WisdomSemestreI/Documentacion/WISDOM-GanntFinal.pdf

# SPARC - Wisdom

Recurso y Entregable

1 | Requerimientos | Lista electrónica
1 | Requerimientos | Lista electrónica
2 | Diseño estructural | Dibujo 2D del CAD
2 | Diseño estructural | Dibujo 2D del CAD
3 | Diseño Electrónico | Esquemático Digital
3 | Diseño Electrónico | Esquemático Digital
4 | Lista de Materiales | Excel
4 | Lista de Materiales | Excel
5 | Desarrollo de software | Github
5 | Desarrollo de software | Github
6 | Ensamblado final | Dispositivo
6 | Ensamblado final | Dispositivo
7 | Pruebas | Tabla de Pruebas
7 | Pruebas | Tabla de Pruebas
8 | Presentaciones | Documento digital e
| | impreso
8 | Presentaciones | Documento digital e
| | impreso
8.1 | Presentación 1: Semana inmersión 1 | Documento digital e
| | impreso
8.1 | Presentación 1: Semana inmersión 1 | Documento digital e
| | impreso
8.2 | Presentación avance Profe Cienfuegos | Documento digital
8.2 | Presentación avance Profe Cienfuegos | Documento digital
8.3 | Presentación 2: Semana inmersión 2 | Documento digital e
| | impreso
8.3 | Presentación 2: Semana inmersión 2 | Documento digital e
| | impreso
8.4 | Presentación avance Profe Cienfuegos | Documento digital
8.4 | Presentación avance Profe Cienfuegos | Documento digital

RESPONSABLE DEL PROYECTO

NÚMERO
EDT | TÍTULO DE LA TAREA

TÍTULO DEL PROYECTO

8.5 | Aprobación del Proyecto
8.5 | Aprobación del Proyecto

SPARC

Adriana L. Avitia, Arael Alvarez, Fernando Escudero

2 | 3 | 4 | 5 | 6 | 9 | 10 | 11 | 12 | 13 | 16 | 17 | 18 | 19 | 20 | 23 | 24 | 25 | 26

Adry

Adry

Fer

Fer

Adry

Adry

Adry

Adry

Ara

Ara

Ara

Ara

Fer

Fer

Adry

Adry

Adry

Adry

Adry

Adry

Adry

Adry

Adry

Adry

04/09/19

RESPONSABLE DE LA TAREA

FASE 1: REQUERIMIENTOS Y DISEÑO

SEMANA 4 | SEMANA 5 | SEMANA 6
L | M | X | J | V | L | M | X | J | V | L | M | X | J | V | L | M | X | J

SEPTIEMBRE

SEMANA 7

NOMBRE DE LA EMPRESA Tec de Monterrey Campus Chihuahua

FECHA

Etapa 1

FASE 2: MATERIALES Y FASE 3: DESARROLLO DE SOFTWARE

Realización Planeada

Fecha importante | Realización Real
V | L | M | X | J | V | L | M | X | J | V | L | M | X | J | V | L | M | X | J | V | L | M | X | J
27 | 30 | 1 | 2 | 3 | 4 | 7 | 8 | 9 | 10 | 11 | 14 | 15 | 16 | 17 | 18 | 21 | 22 | 23 | 24 | 25 | 28 | 29 | 30 | 31

OCTUBRE

SEMANA 8 | SEMANA 9 | SEMANA 10 | SEMANA 11 | SEMANA 12

Etapa 2

FASE 4: EMSAMBLAJE Y PRUEBAS

1 | 4 | 5 | 6 | 7 | 8 | 11 | 12 | 13 | 14 | 15 | 18 | 19 | 20 | 21 | 22 | 25 | 26 | 27 | 28 | 29 | 2 | 3 | 4 | 5
SEMANA 14 | SEMANA 15 | SEMANA 16 | SEMANA 17
NOVIEMBRE | DICIEMBRE

SEMANA 13

V | L | M | X | J | V | L | M | X | J | V | L | M | X | J | V | L | M | X | J | V | L | M | X | J

Etapa 3

FASE 5: CORRECIONES Y PRESENTACIÓN

V

6
