WisdomSemestreI/Documentacion/Arquitectura de software.png

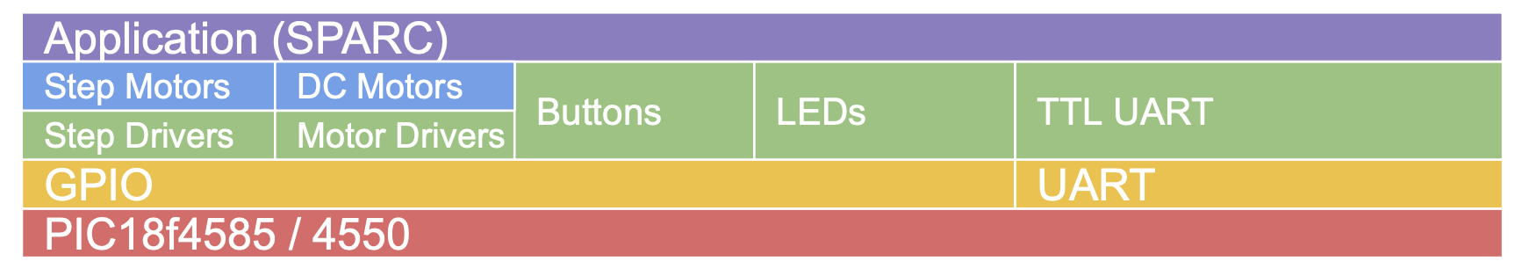
Arquitectura de software.png
