WisdomSemestreI/Documentacion/DeploymentDiagram.png

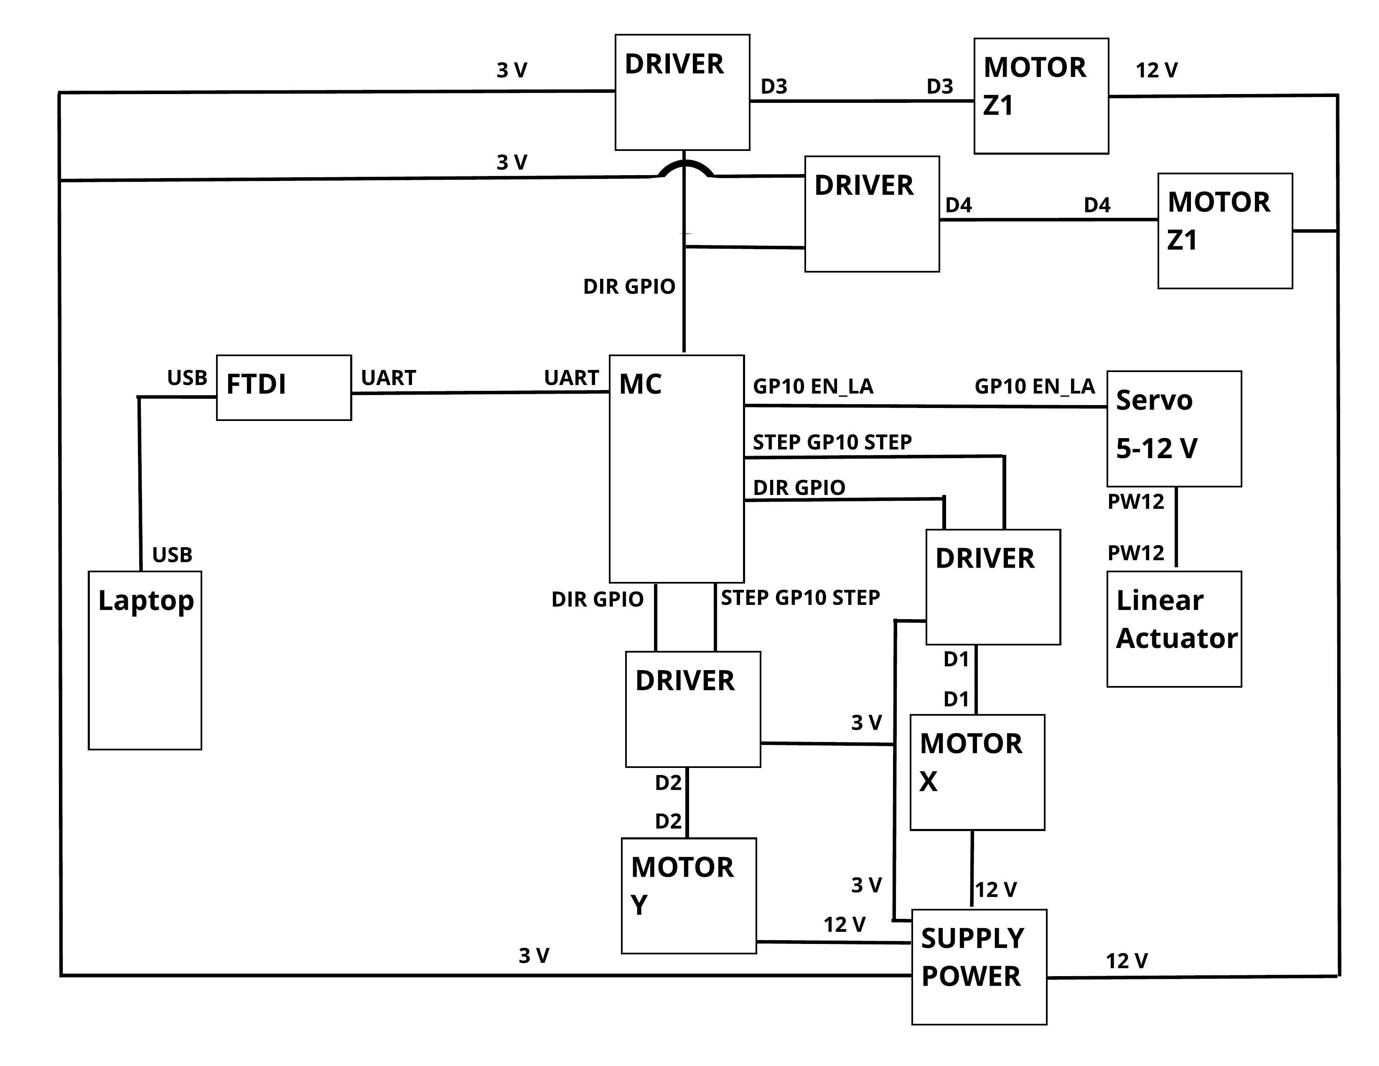
DeploymentDiagram.png
