WisdomSemestreI/Documentacion/Diagrama de Flujo.png

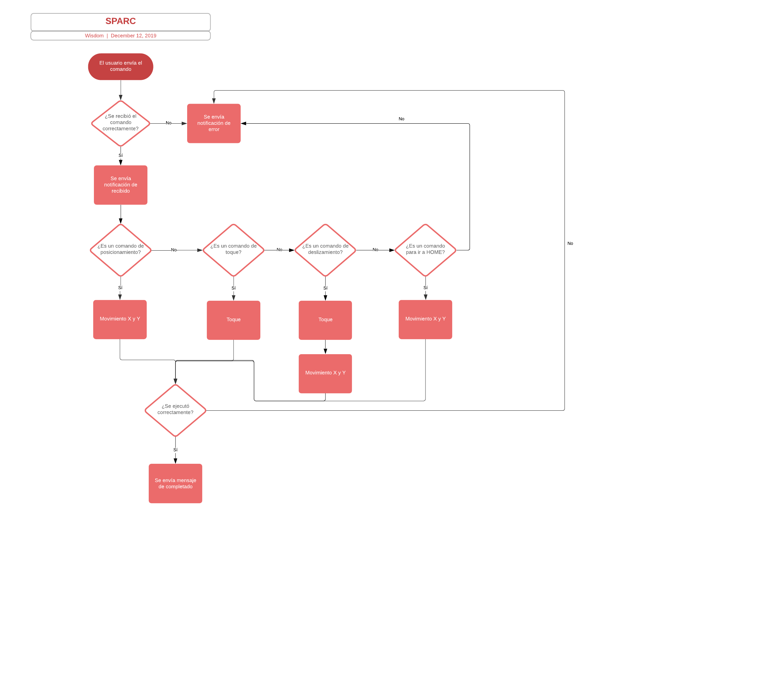
Diagrama de Flujo.png
