WisdomSemestreI/Documentacion/BOM.xlsx

Name | Description | Supplier | Supplier's Piece Number | Unit Cost USD | Unit Cost MN | Quantity | Total Cost USD | Total Cost MN | Where to find
1 | Strucure | PEI Productos y Equipos Industriales | Various | NA | NA | 1 | NA | 2280 | Varias
1.1 | 2020 Alum 420 | PEI Productos y Equipos Industriales | P20-2020-420CM | NA | 26 | 4 | NA | 104 | https://8020.net/20-2020.html
1.2 | 2020 Alum 450 | PEI Productos y Equipos Industriales | P20-2020-450CM | NA | 28 | 4 | NA | 112 | https://8020.net/20-2020.html
1.3 | 2040 Alum 460 | PEI Productos y Equipos Industriales | P20-2040-460CM | NA | 975 | 2 | NA | 1950 | https://8020.net/20-2040.html
1.4 | 2020 Alum 460 | PEI Productos y Equipos Industriales | P20-2020-460CM | NA | 57 | 2 | NA | 114 | https://8020.net/20-2020.html
1.5 | Angles of 2 screws, R#5, P20 | PEI Productos y Equipos Industriales | 14060 | 0.74 | NA | 16 | 11.84 | NA | https://8020.net/14060.html
1.6 | Flat Nut, Thread M5-0.8, R # 5, P20 | PEI Productos y Equipos Industriales | 14122 | 0.21 | NA | 32 | 6.72 | NA | https://8020.net/14122.html
1.7 | BHSCS M5-0.8 x 8 MM screw | PEI Productos y Equipos Industriales | 1245053 | 0.32 | NA | 32 | 10.24 | NA | https://8020.net/11-5308.html
3 | Motor Base Support | Equipo Desarrollador - Impreso en 3D | 3 | NA | NA | 2 | NA | NA | Equipo Desarrollador - Impreso en 3D
7 | Flexible couple aluminium 5mm x 8mm | Maquinaria y Control | Cople flexible | NA | 31 | 2 | NA | 62 | http://maquinariaycontrol.com.mx/tienda/acople-flexible3-10?search=Cople%205x8
11 | Husillo Cuerda Trapezoidal 12mm diámetro con dos tuercas | Maquinaria y Control | ACME 12MM | NA | 997 | 2 | NA | 1994 | http://maquinariaycontrol.com.mx/tienda/husillo12mm?search=Tornillo%20acme
14 | KP08 Chumacera | Maquinaria y Control | KP08 | NA | 40 | 2 | NA | 80 | http://maquinariaycontrol.com.mx/tienda/KP08?search=Chumacera
15 | 608ZZ Bearing | Maquinaria y Control | Balero 608ZZ | NA | 5.5 | 4 | NA | 22 | http://maquinariaycontrol.com.mx/tienda/608ZZ?search=Balero
16 | Base-Mounted Shaft Supports | McMaster-Carr | 61815K33 | 21.21 | 0 | 4 | 84.84 | 0 | https://www.mcmaster.com/shaft-holders
17 | Rotary Shafts | McMaster-Carr | 1265K67 | 46.87 | 0 | 4 | 187.48 | 0 | https://www.mcmaster.com/catalog/125/1171
18 | Solenoid Cart | Varios | Various | NA | NA | 1 | 199.56 | 382
18.2 | GT2 toothed pulley 20 teeth for 6 mm belt | Maquinaria y Control | Polea 20 dientes GT2 | NA | 19 | 1 | NA | 19 | http://maquinariaycontrol.com.mx/tienda/polea-20d-6mm?search=polea
18.3 | Alloy Steel Socket Head Screws | McMaster-Carr | 91290A113 | 3.37 | NA | 8 | 26.96 | NA | https://www.mcmaster.com/catalog/125/3204
18.6 | Metric Medium-Strength Steel Hex Nuts—Class 8 | McMaster-Carr | 90592A095 | 1.76 | NA | 22 | 38.72 | NA | https://www.mcmaster.com/hex-nuts
18.7 | 18-8 Stainless Steel Pan Head Phillips Screws | McMaster-Carr | 91772A838 | 7.65 | NA | 4 | 30.6 | NA | https://www.mcmaster.com/tornillo-10-32-phillips
18.8 | Solid Wheel V Polyoxymethylene 5mm Small | Maquinaria y Control | Rueda Solida V chica | NA | 43 | 4 | NA | 172 | http://maquinariaycontrol.com.mx/tienda/rueda-v-ch?search=rueda
19 | Y /Cart | Varios | Various | NA | NA | 2 | 103.28 | 191
19.2 | GT2 toothed pulley 20 teeth for 6mm belt | Maquinaria y Control | Polea 20 dientes GT2 | NA | 19 | 1 | NA | 19 | http://maquinariaycontrol.com.mx/tienda/polea-20d-6mm?search=polea
19.3 | Solid Wheel V Polyoxymethylene 5mm Small | Maquinaria y Control | Rueda Solida V chica | NA | 43 | 4 | NA | 172 | http://maquinariaycontrol.com.mx/tienda/rueda-v-ch?search=rueda
19.4 | 18-8 Stainless Steel Pan Head Phillips Screws | McMaster-Carr | 91772A838 | 7.65 | NA | 4 | 30.6 | NA | https://www.mcmaster.com/tornillo-10-32-phillips
19.5 | Metric Medium-Strength Steel Hex Nuts—Class 8 | McMaster-Carr | 90592A095 | 1.76 | NA | 22 | 38.72 | NA | https://www.mcmaster.com/hex-nuts
19.6 | Medium-Strength Metric Class 8.8 Steel Hex Head Screws | McMaster-Carr | 91280A102 | 8.49 | NA | 4 | 33.96 | NA | https://www.mcmaster.com/screws
20 | 2040 Alum 467 | PEI Productos y Equipos Industriales | P20-2040-460CM | NA | 496 | 1 | NA | 496 | https://8020.net/20-2040.html
21 | 18-8 Stainless Steel Pan Head Phillips Screws | McMaster-Carr | 91772A838 | 7.65 | NA | 4 | 30.6 | NA | https://www.mcmaster.com/tornillo-10-32-phillips
22 | 18-8 Stainless Steel Pan Head Phillips Screws | McMaster-Carr | 91772A838 | 7.65 | NA | 4 | 30.6 | NA | https://www.mcmaster.com/tornillo-10-32-phillips
25 | Alloy Steel Socket Head Screws | McMaster-Carr | 91290A113 | 3.37 | NA | 8 | 26.96 | NA | https://www.mcmaster.com/catalog/125/3204
26 | Flat Nut, Thread M5-0.8, R # 5, P20 | PEI Productos y Equipos Industriales | 14122 | 0.21 | NA | 32 | 6.72 | NA | https://8020.net/14122.html
27 | Alloy Steel Socket Head Screws | McMaster-Carr | 91290A113 | 3.37 | NA | 8 | 26.96 | NA | https://www.mcmaster.com/catalog/125/3204
28 | Metric Medium-Strength Steel Hex Nuts—Class 8 | McMaster-Carr | 90592A095 | 1.76 | NA | 22 | 38.72 | NA | https://www.mcmaster.com/hex-nuts
29 | Alloy Steel Socket Head Screws | McMaster-Carr | 91290A113 | 3.37 | NA | 8 | 26.96 | NA | https://www.mcmaster.com/catalog/125/3204
31 | Alloy Steel Socket Head Screws | McMaster-Carr | 91290A113 | 3.37 | NA | 8 | 26.96 | NA | https://www.mcmaster.com/catalog/125/3204
32 | Metric Medium-Strength Steel Hex Nuts—Class 8 | McMaster-Carr | 90592A095 | 1.76 | NA | 22 | 38.72 | NA | https://www.mcmaster.com/hex-nuts
33 | Alloy Steel Socket Head Screws | McMaster-Carr | 91290A113 | 3.37 | NA | 8 | 26.96 | NA | https://www.mcmaster.com/catalog/125/3204
34 | Flat Nut, Thread M5-0.8, R # 5, P20 | PEI Productos y Equipos Industriales | 14122 | 0.21 | NA | 32 | 6.72 | NA | https://8020.net/14122.html
35 | Alloy Steel Socket Head Screws | McMaster-Carr | 91290A113 | 3.37 | NA | 8 | 26.96 | NA | https://www.mcmaster.com/catalog/125/3204
36 | Metric Medium-Strength Steel Hex Nuts—Class 8 | McMaster-Carr | 90592A095 | 1.76 | NA | 22 | 38.72 | NA | https://www.mcmaster.com/hex-nuts
37 | Alloy Steel Socket Head Screws | McMaster-Carr | 91290A113 | 3.37 | NA | 8 | 26.96 | NA | https://www.mcmaster.com/catalog/125/3204
39 | Alloy Steel Socket Head Screws | McMaster-Carr | 91290A113 | 3.37 | NA | 8 | 26.96 | NA | https://www.mcmaster.com/catalog/125/3204
40 | Metric Medium-Strength Steel Hex Nuts—Class 8 | McMaster-Carr | 90592A095 | 1.76 | NA | 22 | 38.72 | NA | https://www.mcmaster.com/hex-nuts
100uF Capacitor Nichicon | Aluminum electrolytic capacitors 100µF 450V Radial, encapsulated 2000 h at 105 ° C | Digi-Key Electronics | 493-11302-ND | 3.82 | NA | 3 | 11.46 | NA | https://www.digikey.com.mx/product-detail/es/nichicon/UPZ2W101MHD/493-11302-ND/4319367
100uF Capacitor Panasonic | Aluminum electrolytic capacitors 100µF 50V Radial, encapsulated 2000 h at 85 ° C | Digi-Key Electronics | P10397TB-ND | 0.0817 | NA | 2 | 0.1634 | NA | https://www.digikey.com.mx/product-detail/es/panasonic-electronic-components/ECA-1HM101B/P10397TB-ND/268482
18 pin DIP Socket 7.62mm Weight | 14 (2 x 7) Pos DIP, row separation of 0.3" (7.62mm) Tin Socket Through Hole | Digi-Key Electronics | AE9989-ND | 0.22 | NA | 2 | 0.44 | NA | https://www.digikey.com.mx/product-detail/es/assmann-wsw-components/A-14-LC-TT/AE9989-ND/821743
3D Printed Elements | 3D Printed | Equipo Desarrollador - Impreso en 3D | Various | 29 | NA | 1 | 29 | NA | https://www.homedepot.com/p/Dremel-White-KG-PLA-Filament-for-Idea-Builder-3D-Printer-DF01-01/205477332
3D Printed Elements 23 | Bracket | Equipo Desarrollador - Impreso en 3D | 23 | NA | NA | 6 | NA | NA | Equipo Desarrollador - Impreso en 3D
3D Printed Elements 24 | Bracket cover | Equipo Desarrollador - Impreso en 3D | 24 | NA | NA | 6 | NA | NA | Equipo Desarrollador - Impreso en 3D
3D Printed Elements 9 | Copule central z axes | Equipo Desarrollador - Impreso en 3D | 9 | NA | NA | 2 | NA | NA | Equipo Desarrollador - Impreso en 3D
4.7K Ohm Resistor | Through hole resistors Axial Fire retardant coating, safety Carbon film 4.7 kOhms ±5% 0.25W, 1/4W | Digi-Key Electronics | CF14JT4K70CT-ND | 0.04 | NA | 17 | 0.68 | NA | https://www.digikey.com.mx/product-detail/es/stackpole-electronics-inc/CF14JT4K70/CF14JT4K70CT-ND/1830366
40 pin DIP Socket 15.24mm Weight | Base for integrated circuit. 40 (2 x 20) Pos DIP, row separation of 0.6" (15.24mm) Tin Socket Through Hole | Digi-Key Electronics | ED90059-ND | 1.82 | NA | 1 | 1.82 | NA | https://www.digikey.com.mx/product-detail/es/mill-max-manufacturing-corp/110-44-640-41-001000/ED90059-ND/947067
A4988 Pololu Stepper Driver | This breakout board for Allegro’s A4988 microstepping bipolar stepper motor driver features adjustable current limiting, over-current and over-temperature protection, and five different microstep resolutions (down to 1/16-step). It operates from 8 V to 35 V and can deliver up to approximately 1 A per phase without a heat sink or forced air flow (it is rated for 2 A per coil with sufficient additional cooling). This board ships with 0.1″ male header pins included but not soldered in. | Pololu Robotics & Electronics | 2980 | 7.45 | NA | 3 | 22.35 | NA | https://www.pololu.com/product/2980
Acrylic Elements | Elements Corated in Acrylic by the Developer Team | Equipo Desarrollador - Cortado en Acrílico | Various | 129 | NA | 2 | 258 | NA | https://www.homedepot.com/p/OPTIX-48-in-x-96-in-x-1-8-in-Clear-Acrylic-Sheet-MC-100S/205351353
Acrylic Elements 10 | Module Base | Equipo Desarrollador - Cortado en Acrílico | 10 | NA | NA | 1 | NA | NA | Equipo Desarrollador - Cortado en Acrílico
Acrylic Elements 12 | Base extension | Equipo Desarrollador - Cortado en Acrílico | 12 | NA | NA | 2 | NA | NA | Equipo Desarrollador - Cortado en Acrílico
Acrylic Elements 13 | Acrylic cover2 | Equipo Desarrollador - Cortado en Acrílico | 13 | NA | NA | 1 | NA | NA | Equipo Desarrollador - Cortado en Acrílico
Acrylic Elements 18.1 | X_Axis _cart (acrílico) | Equipo Desarrollador - Cortado en Acrílico | 18.A | NA | NA | 1 | NA | NA | Equipo Desarrollador - Cortado en Acrílico
Acrylic Elements 18.5 | Extender Solenoid | Equipo Desarrollador - Cortado en Acrílico | 18.E | NA | NA | 1 | NA | NA | Equipo Desarrollador - Cortado en Acrílico
Acrylic Elements 19.1 | Y axis coupling | Equipo Desarrollador - Cortado en Acrílico | 19.A | NA | NA | 1 | NA | NA | Equipo Desarrollador - Cortado en Acrílico
Acrylic Elements 2 | Acrylic Base | Equipo Desarrollador - Cortado en Acrílico | 2 | NA | NA | 1 | NA | NA | Equipo Desarrollador - Cortado en Acrílico
Acrylic Elements 30 | Bearing spacer | Equipo Desarrollador - Cortado en Acrílico | 30 | NA | NA | 2 | NA | NA | Equipo Desarrollador - Cortado en Acrílico
Acrylic Elements 38 | Bearing spacer | Equipo Desarrollador - Cortado en Acrílico | 38 | NA | NA | 2 | NA | NA | Equipo Desarrollador - Cortado en Acrílico
Acrylic Elements 4 | Acrylic front part | Equipo Desarrollador - Cortado en Acrílico | 4 | NA | NA | 1 | NA | NA | Equipo Desarrollador - Cortado en Acrílico
Acrylic Elements 5 | Acrylic cover1 | Equipo Desarrollador - Cortado en Acrílico | 5 | NA | NA | 1 | NA | NA | Equipo Desarrollador - Cortado en Acrílico
Acrylic Elements 6 | Acrylic back cover | Equipo Desarrollador - Cortado en Acrílico | 6 | NA | NA | 1 | NA | NA | Equipo Desarrollador - Cortado en Acrílico
Acrylic Elements 8 | Acrylic top cover | Equipo Desarrollador - Cortado en Acrílico | 8 | NA | NA | 1 | NA | NA | Equipo Desarrollador - Cortado en Acrílico
Button Switch Arcade | Standard SPDT button Panel mount, front | Digi-Key Electronics | 1568-1476-ND | 2.5 | NA | 4 | 10 | NA | https://www.digikey.com.mx/product-detail/es/sparkfun-electronics/COM-09336/1568-1476-ND/6047815
Compuerta 74LS02 NOT | Inverter IC 6 Channel 14-PDIP | Digi-Key Electronics | 296-1629-5-ND | 0.73 | NA | 1 | 0.73 | NA | https://www.digikey.com.mx/product-detail/es/texas-instruments/SN74LS04N/296-1629-5-ND/277275
Compuerta 74LS32 OR | Gate OR IC 4 Channel 14-PDIP | Digi-Key Electronics | 296-1658-5-ND | 0.61 | NA | 1 | 0.61 | NA | https://www.digikey.com.mx/product-detail/es/texas-instruments/SN74LS32N/296-1658-5-ND/277304
DC Motor | 12 V Direct Current Motor 30 mm diameter 46.3 rpm 392mNm and 2.1 A | Transmotec | 10080018 | 95 | NA | 2 | 190 | NA | https://www.transmotec.com/product/SD3039-12-120-F/
Electronic Copper Board | Proto Board Fiberglass FR4 12.00 "x 12.00" (304.8mm x 304.8mm) | Digi-Key Electronics | V2041-ND | 15.71 | NA | 1 | 15.71 | NA | https://www.digikey.com.mx/product-detail/es/vector-electronics/12X12WE/V2041-ND/1886434
Female Pin Header | 10 Position Header Connector Through Hole | Digi-Key Electronics | 732-2859-ND | 0.65 | NA | 1 | 0.65 | NA | https://www.digikey.com.mx/product-detail/es/w-rth-elektronik/61301011821/732-2859-ND/2508628
l298N H Bridge Driver | Dual 4.8V-46V and 2A motor controller, which is the revised version of the DF-MDV1.0. Its performance has been highly improved. It can withstand a greater current because it has a greater heat dissipation. It is easy to control, since it uses the LG29 L298N high power motor control chip. This chip allows direct control of 2 bidirectional DC motors, and incorporates high speed short diodes for protection. Current output up to 2A. The controller uses a broad-brush design that reduces the resistance produced by the cables. | MCI Electronics | MCI05429 | 8.79 | NA | 1 | 8.79 | NA | https://www.mcielectronics.cl/en_US/shop/product/l298n-dual-h-bridge-dc-stepper-motor-drive-controller-25508
LED Strip 1m | LED Lighting COBs, Engines, Modules LED Module F Series Gen3 Neutral white Linear light strip | Digi-Key Electronics | 1510-2227-ND | 25.7 | NA | 1 | 25.7 | NA | https://www.digikey.com.mx/product-detail/es/samsung-semiconductor-inc/SI-B8T521B20WW/1510-2227-ND/6624011
Limit Switch | SPDT switch Chassis mount | Digi-Key Electronics | SW156-ND | 2.38 | NA | 4 | 9.52 | NA | https://www.digikey.com.mx/product-detail/es/omron-electronics-inc-emc-div/SS-5GL2/SW156-ND/137204
Male Pin Header 1.00mm | 4 Positions Header Connector 0.100 "(2.54mm) Through Hole Gold | Digi-Key Electronics | 732-5317-ND | 0.1272 | NA | 30 | 3.816 | NA | https://www.digikey.com.mx/product-detail/es/w-rth-elektronik/61300411121/732-5317-ND/4846827
Microcontroller PIC18F4550 | Microcontroller IC PIC PIC® 18F 8 bits 48MHz Flash Memory 32KB (16K x 16) 40-PDIP | Digi-Key Electronics | PIC18F4550-I/P-ND | 4.47 | NA | 1 | 4.47 | NA | https://www.digikey.com.mx/product-detail/es/microchip-technology/PIC18F4550-I-P/PIC18F4550-I-P-ND/704580
ON/OFF Switch | Rocker Switch SPST 15A (AC) 125V Panel mount, snap | Digi-Key Electronics | EG1510-ND | 2.01 | NA | 1 | 2.01 | NA | https://www.digikey.com.mx/product-detail/es/e-switch/R1966ABLKBLKFF/EG1510-ND/210519
JF-0530B / JF-0630B Solenoide 6VDC | Los solenoides son una gran manera de inducir el movimiento lineal para empujar, tirar o controlar interruptores y palancas. Este solenoide pequeño está diseñado para trabajar directamente con 6V y es genial para los proyectos integrados. Tiene una tirada de alrededor de 10mm y 2 agujeros M3 de montaje en el cuerpo. El cable de alambre es de 2" de largo. | MicroJPM | AD40257 | 8.95 | NA | 1 | 8.95 | NA | https://www.microjpm.com/products/ad40257/
Stepper Motor Nema 17 | Bipolar Stepper Hybrid Motor Frame Size 17 200 Step 1.7A 3.4 VDC | Digi-Key Electronics | 1738-1036-ND | 14.09 | NA | 3 | 42.27 | NA | https://www.digikey.com.mx/product-detail/es/dfrobot/FIT0278/1738-1036-ND/6588458
