WisdomSemestreI/Documentacion/Manual Constructivo.pdf

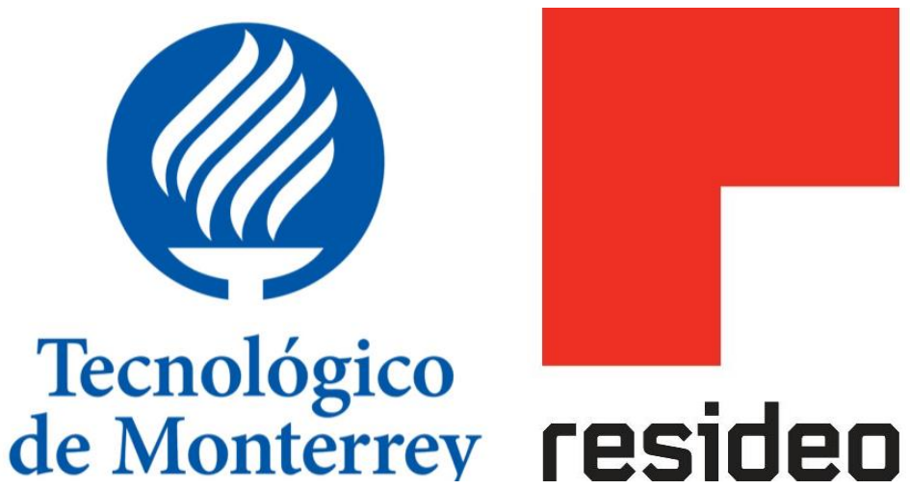
[picture p8: figure]

Tecnológico de Monterrey Campus Chihuahua

Assembly guide of SPARC

Training Partner: Resideo

Involved teams:

Wisdom

Justice

Creativity

Temperance

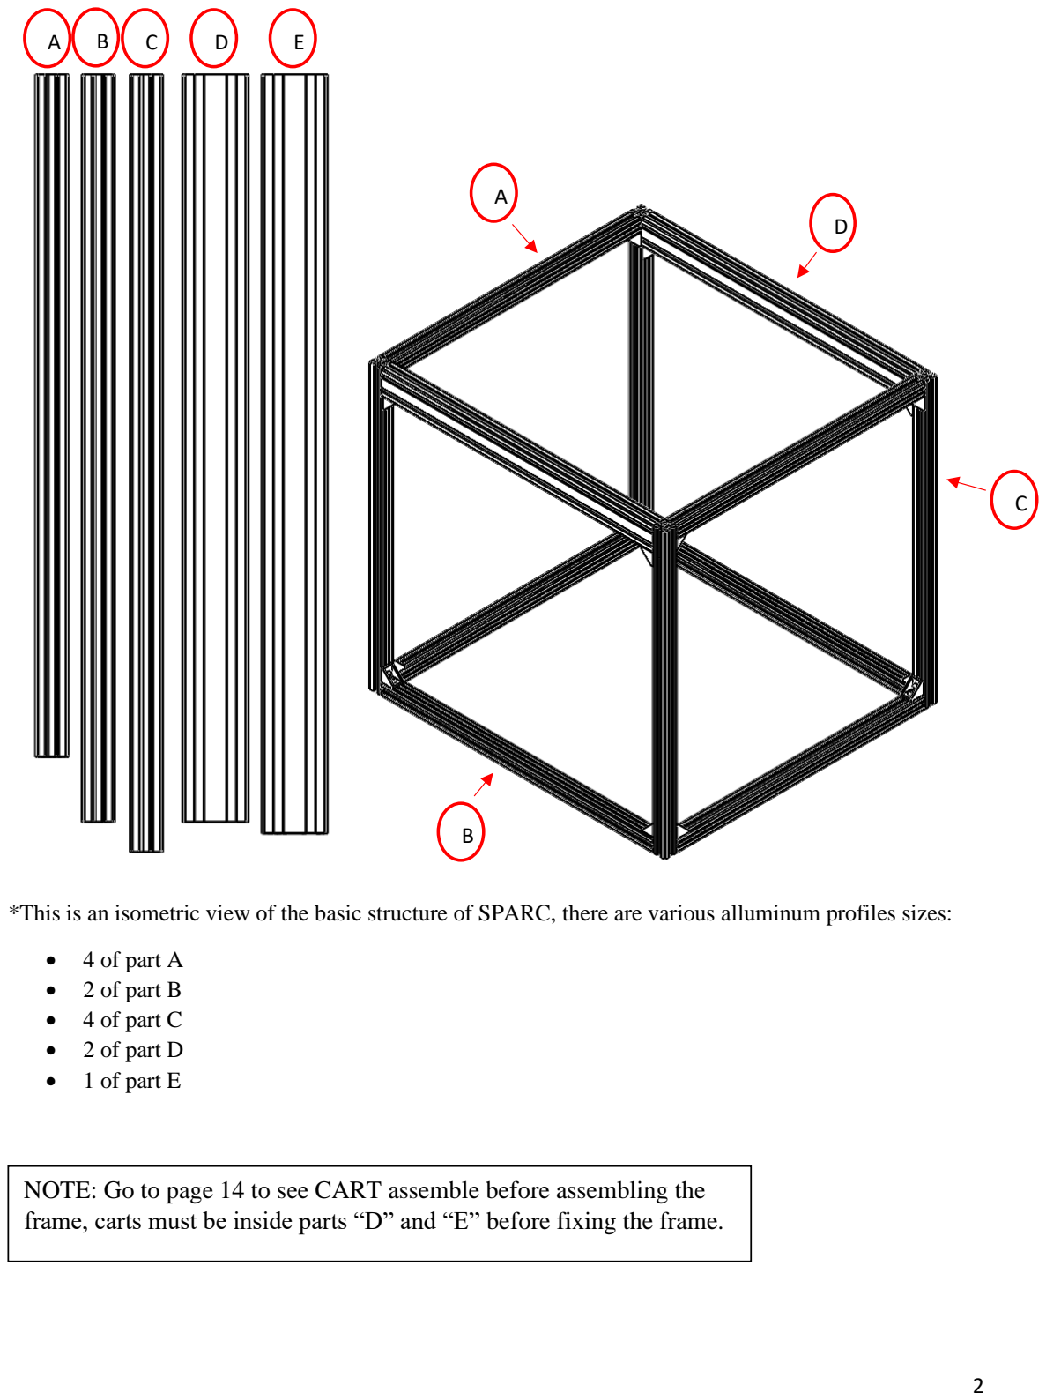
[picture p9: page 2]

*This is an isometric view of the basic structure of SPARC, there are various alluminum profiles sizes:

- 4 of part A
- 2 of part B
- 4 of part C
- 2 of part D
- 1 of part E
A | B | C | D | E

D

C

A

B

NOTE: Go to page 14 to see CART assemble before assembling the frame, carts must be inside parts “D” and “E” before fixing the frame.

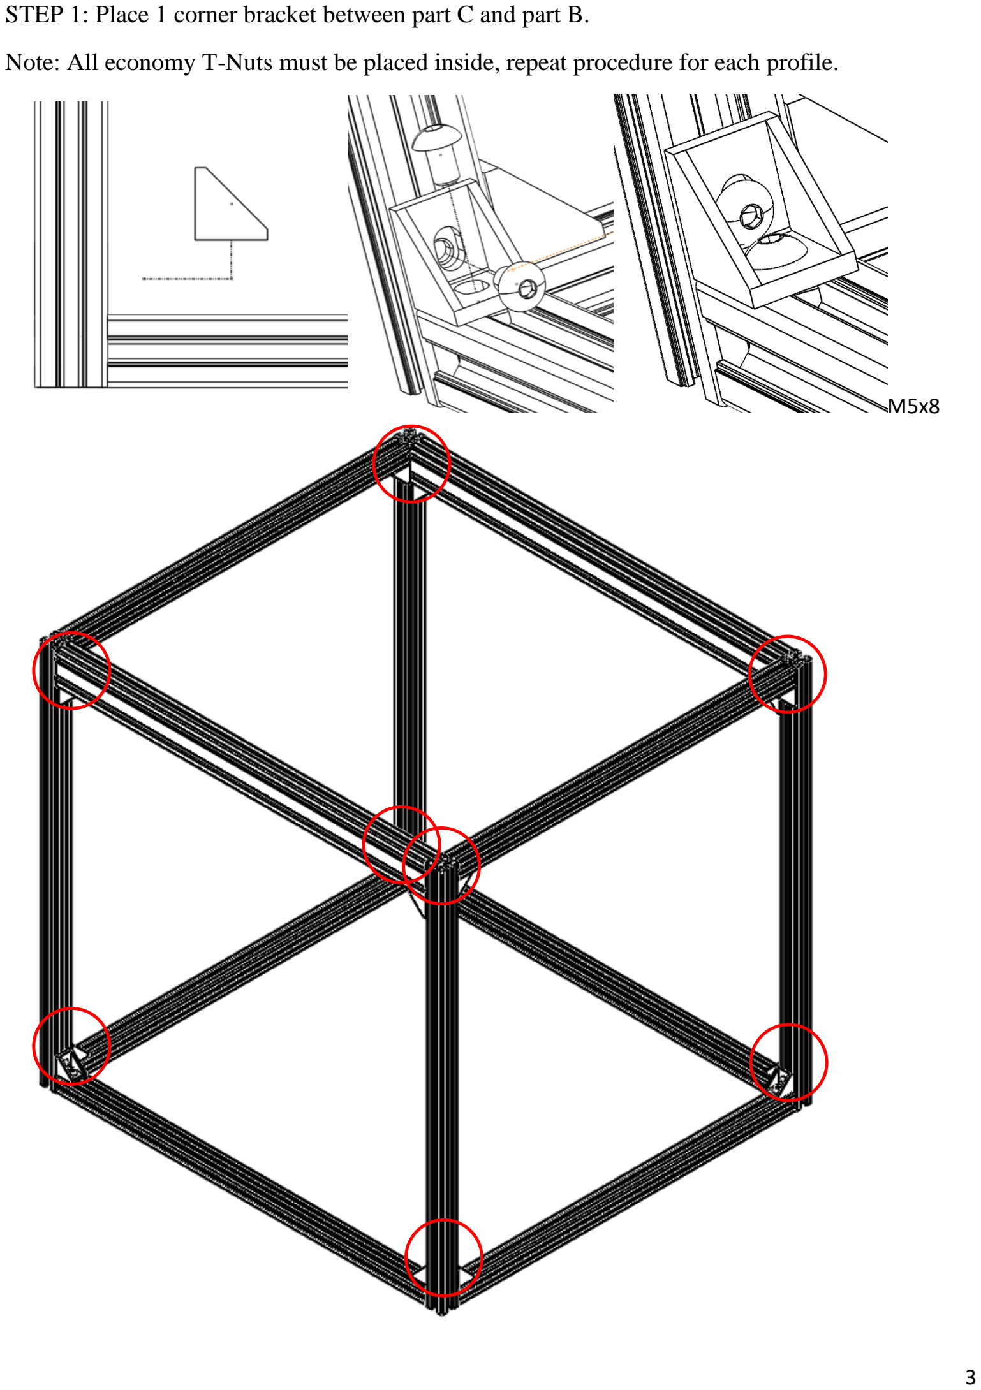
[picture p10: page 3]

STEP 1: Place 1 corner bracket between part C and part B.

Note: All economy T-Nuts must be placed inside, repeat procedure for each profile.

M5x8

Inside look of T-Nut installation

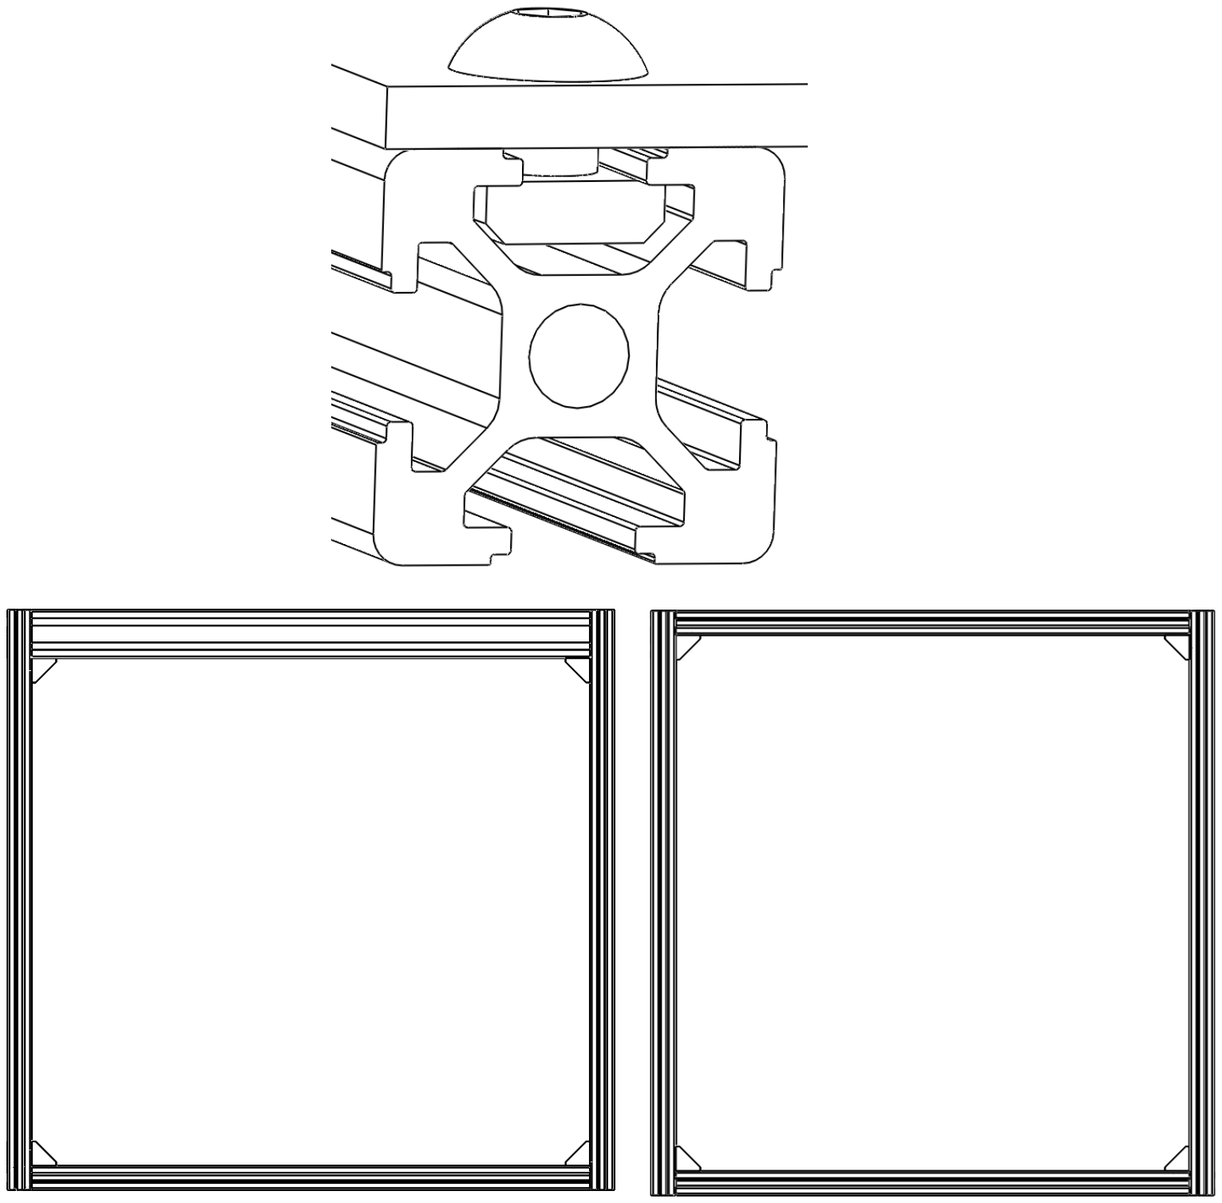
[picture p11: figure]

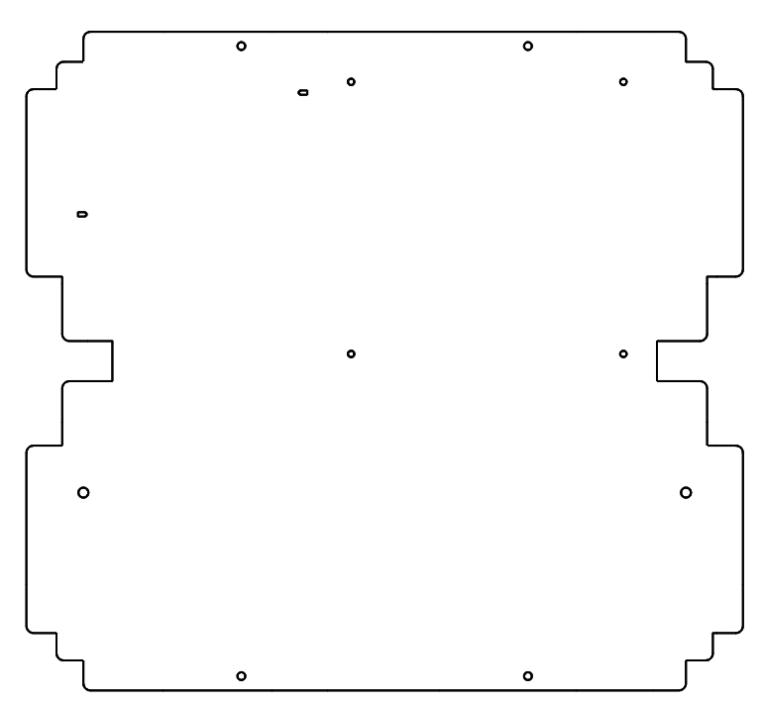
[picture p12: figure]

STEP 2: Use M5x8 bolts to secure the base for the components, a T-Nut for each hole must be inside the rails of the aluminum profile.

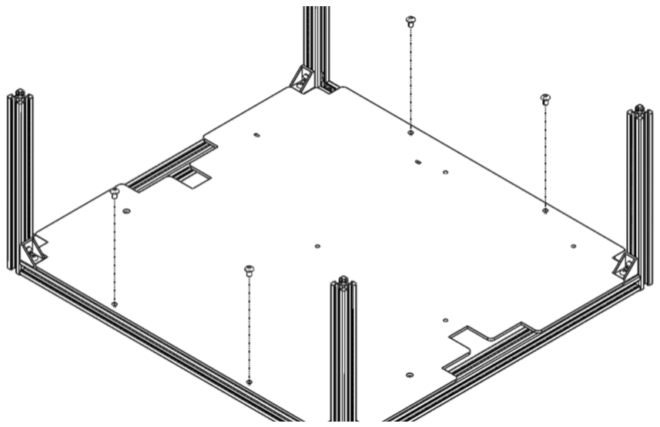
[picture p13: figure]
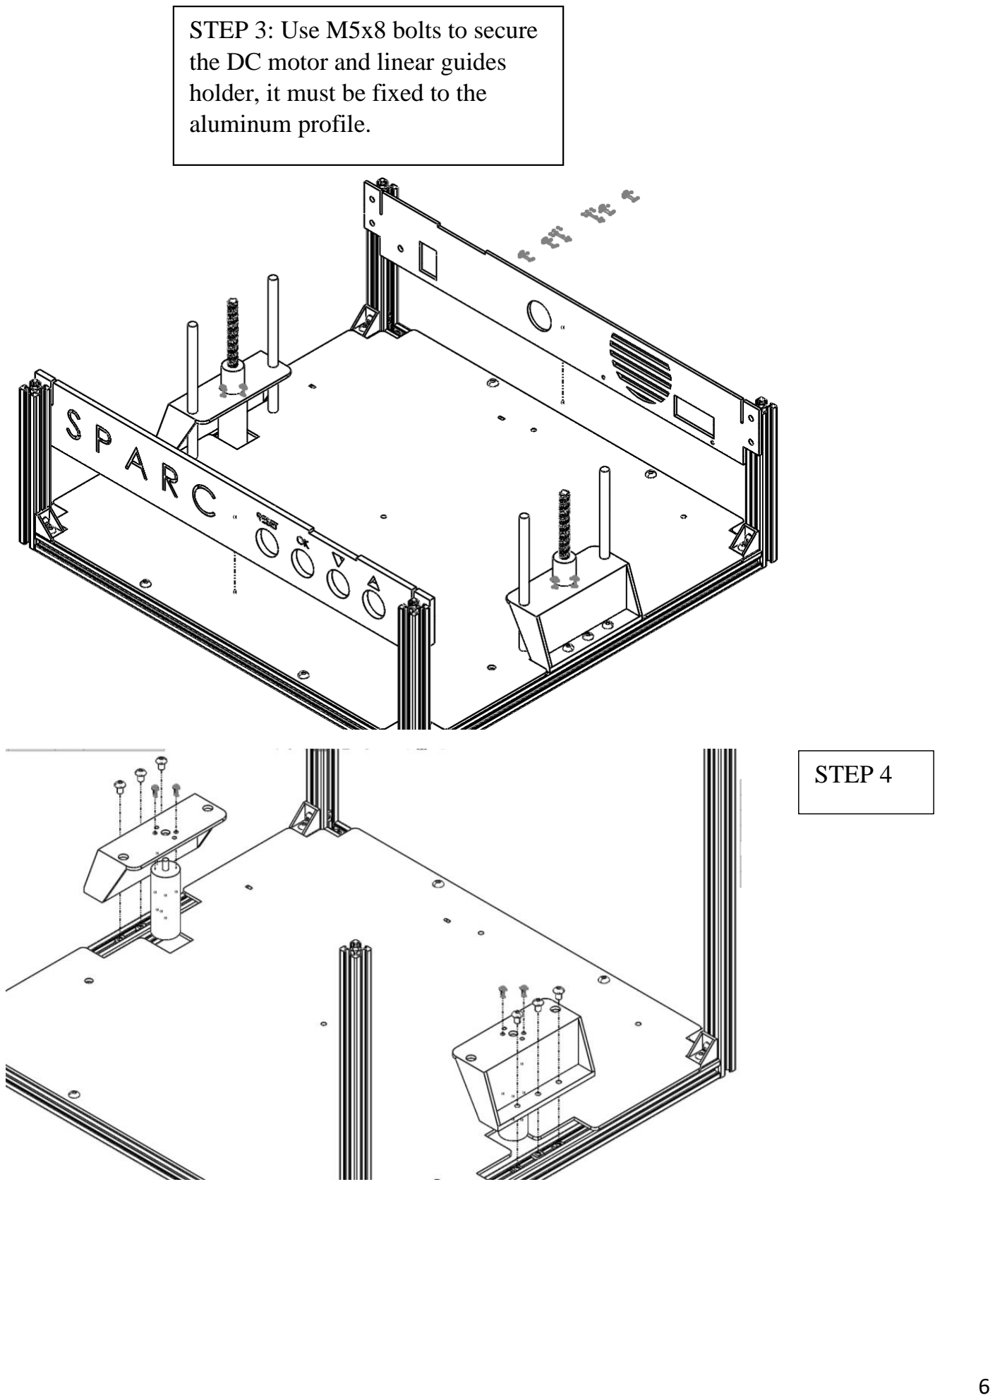
[picture p14: page 6]

STEP 3: Use M5x8 bolts to secure the DC motor and linear guides holder, it must be fixed to the aluminum profile.
STEP 4

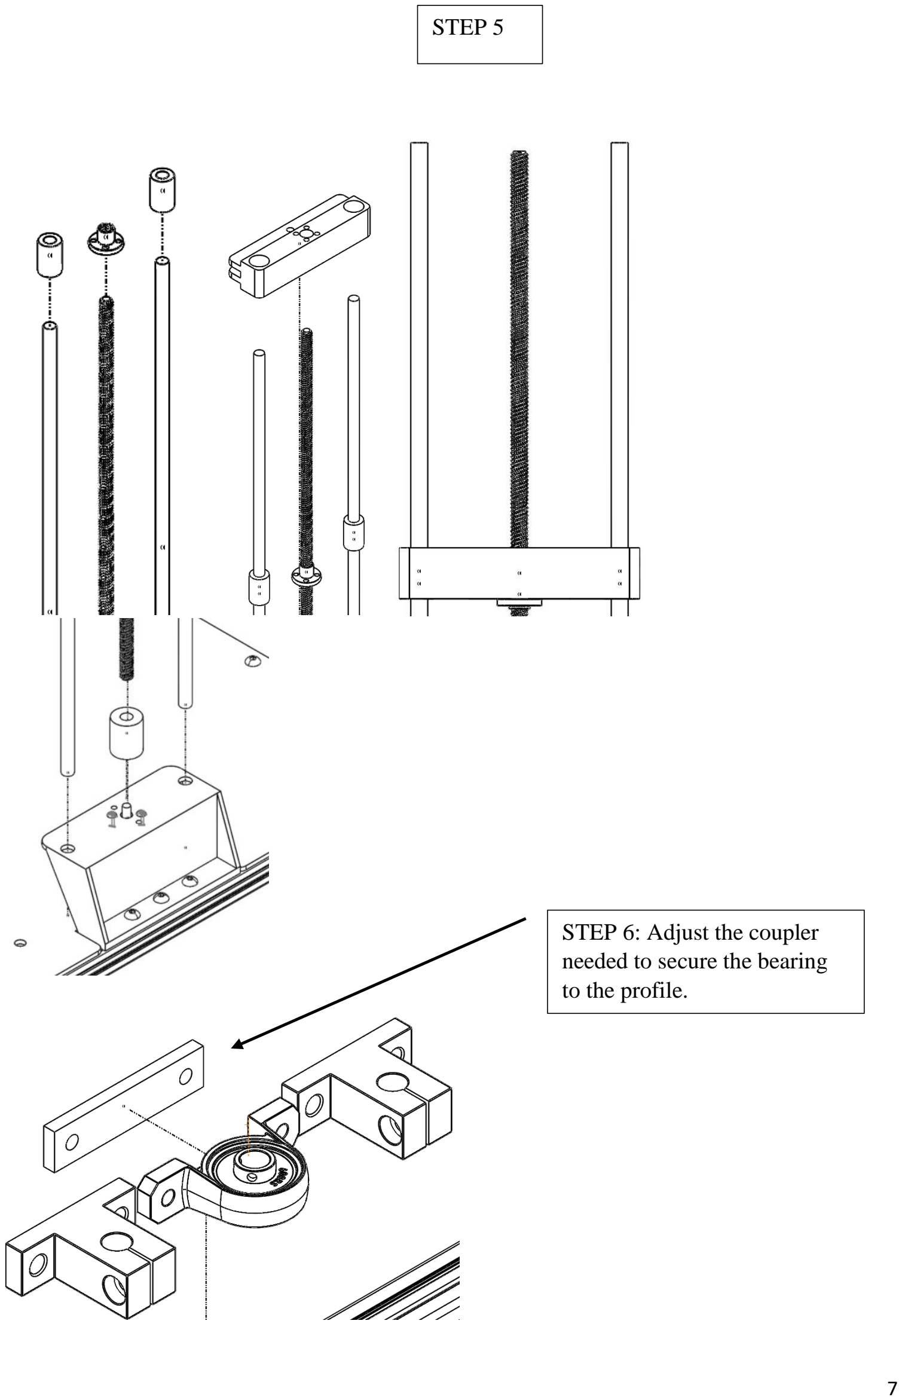
[picture p15: page 7]

STEP 5
STEP 6: Adjust the coupler needed to secure the bearing to the profile.

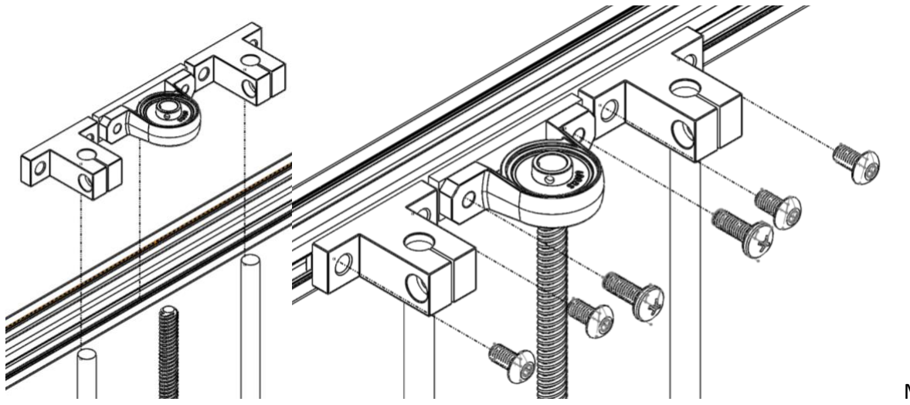
[picture p16: figure]

M5x10 y
M5x14
STEP 7: Fix the guide axis and bearing using 2 T-Nuts for each one, guide axis use M5x14 bolts, bearing holder uses M5x10 bolts.

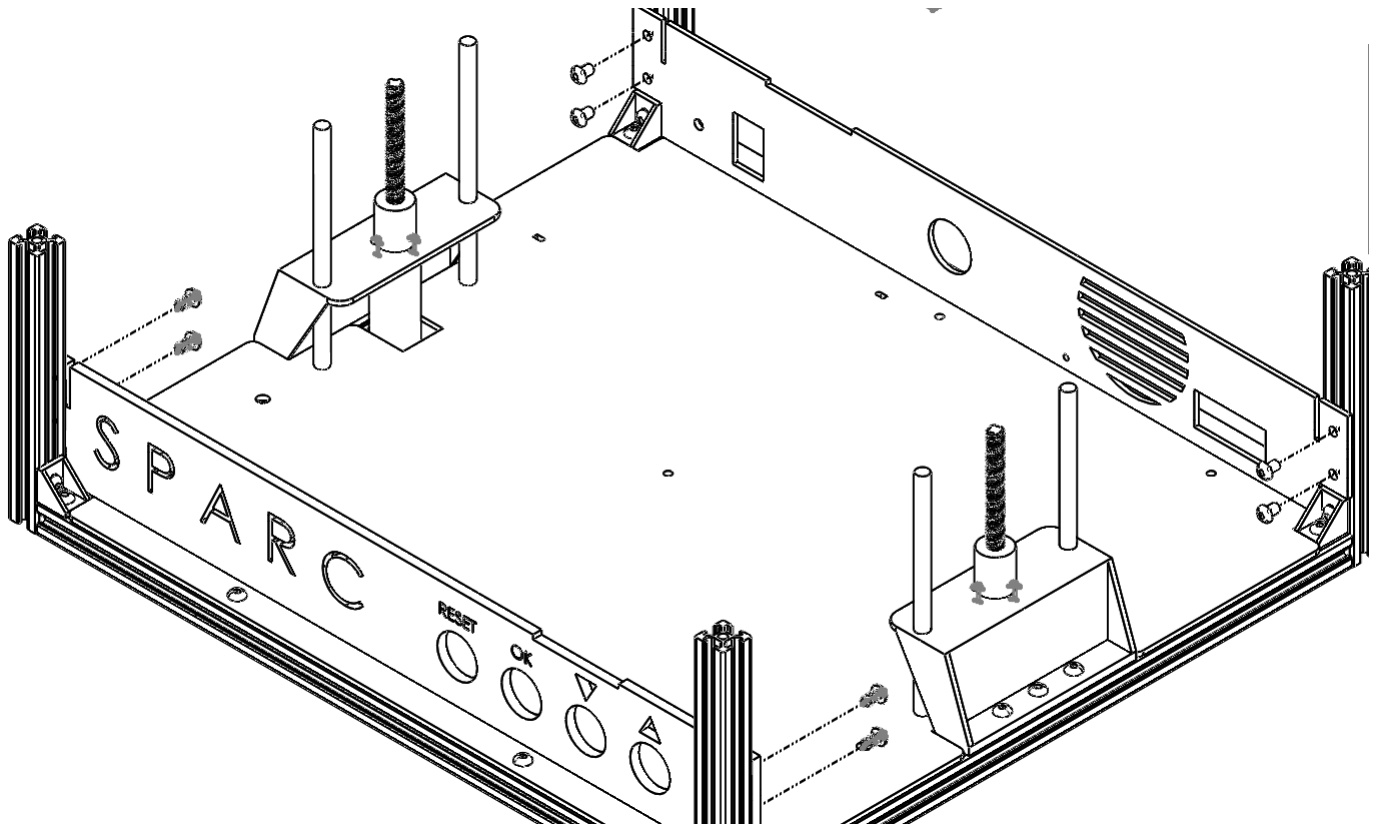
[picture p17: figure]

STEP 8: Use M5x8 bolts and T-Nuts to fix SPARC and VENT walls to the aluminum profile, it uses two T-Nuts and 2 bolts in each corner.

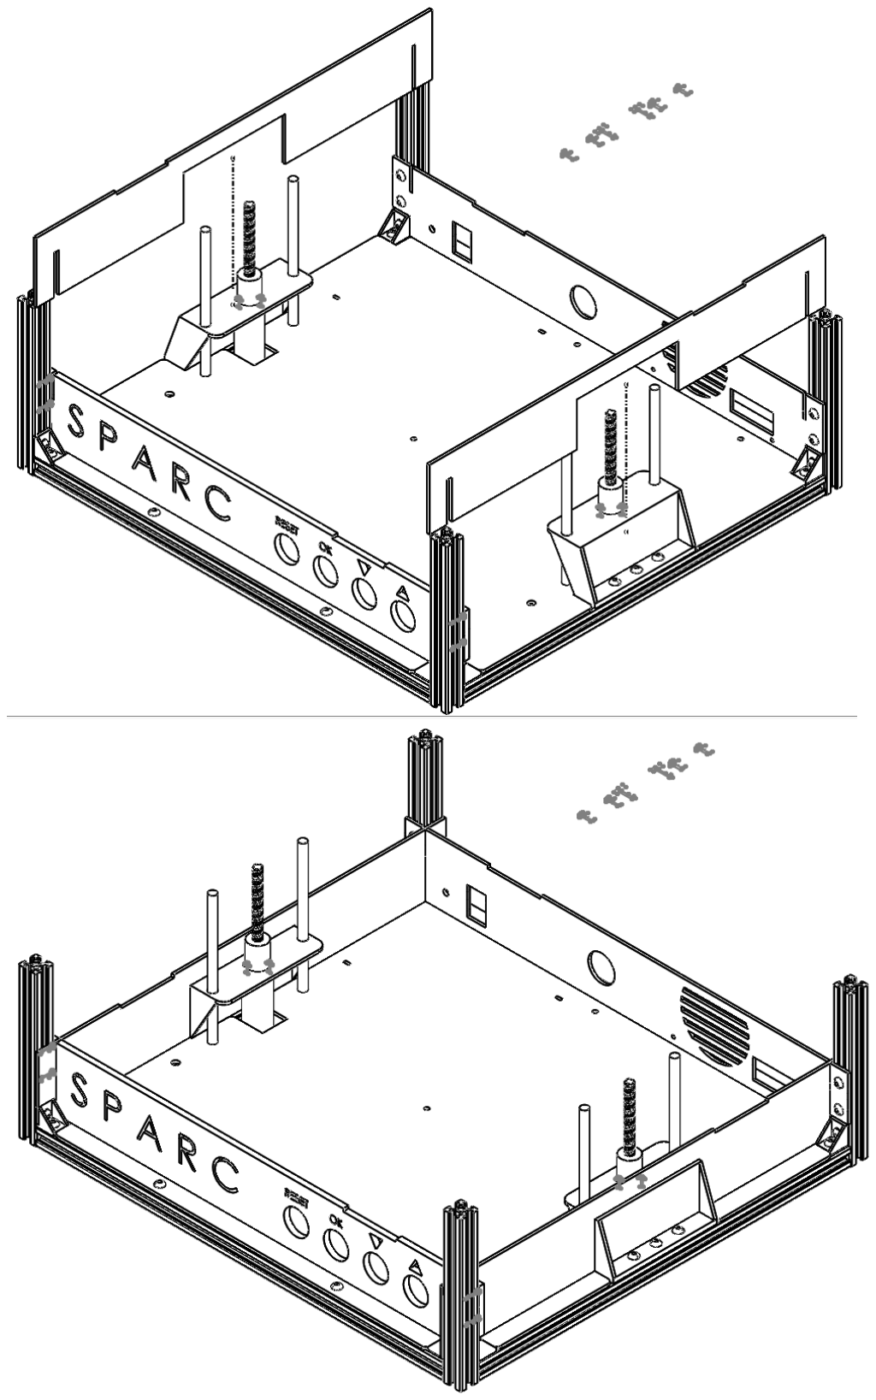
[picture p18: figure]

STEP 9: Place side walls in the grooves cut in the fixed walls.

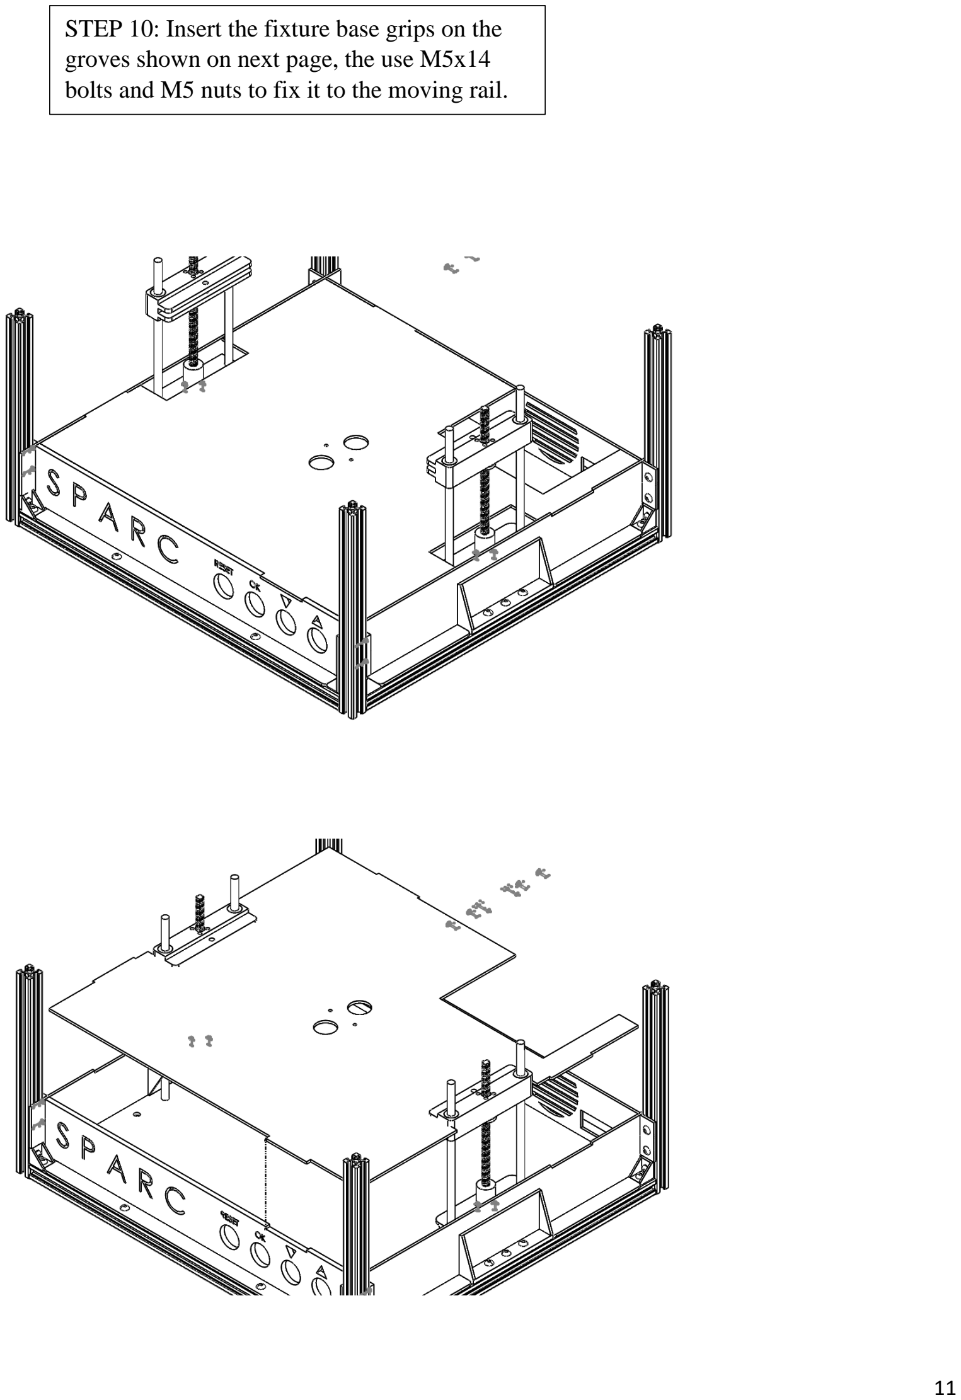
[picture p19: page 11]

STEP 10: Insert the fixture base grips on the groves shown on next page, the use M5x14 bolts and M5 nuts to fix it to the moving rail.

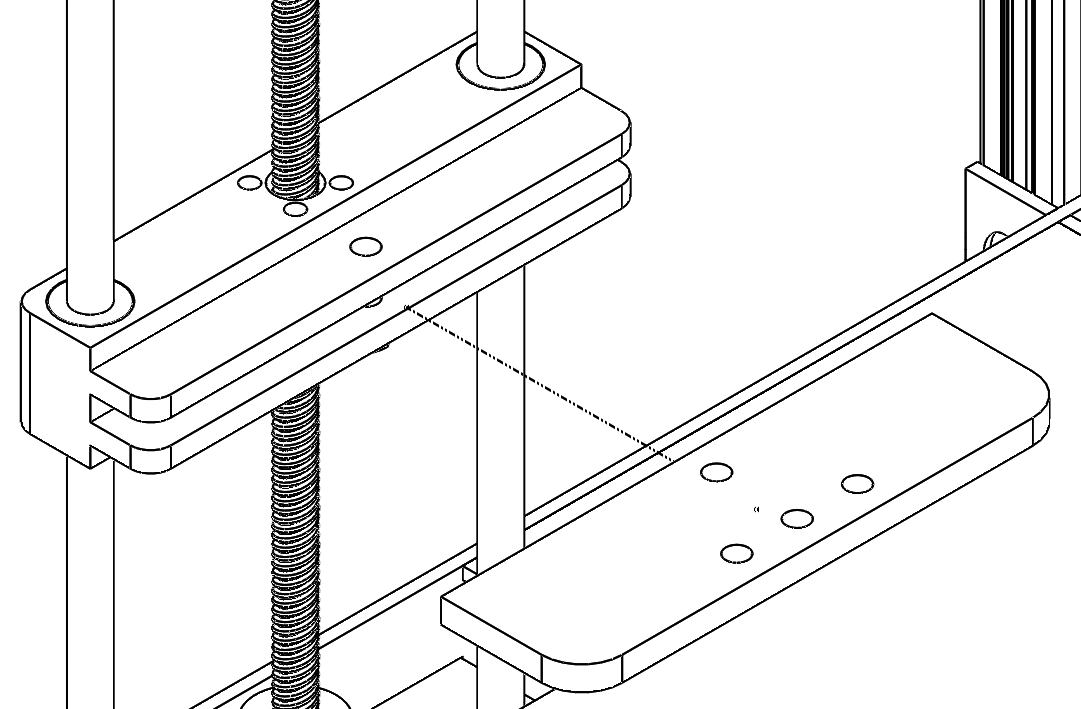
[picture p20: figure]
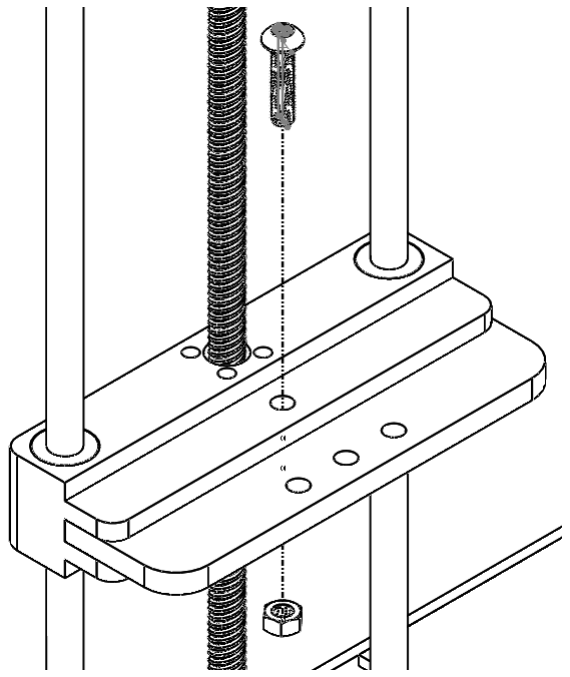
[picture p21: figure]

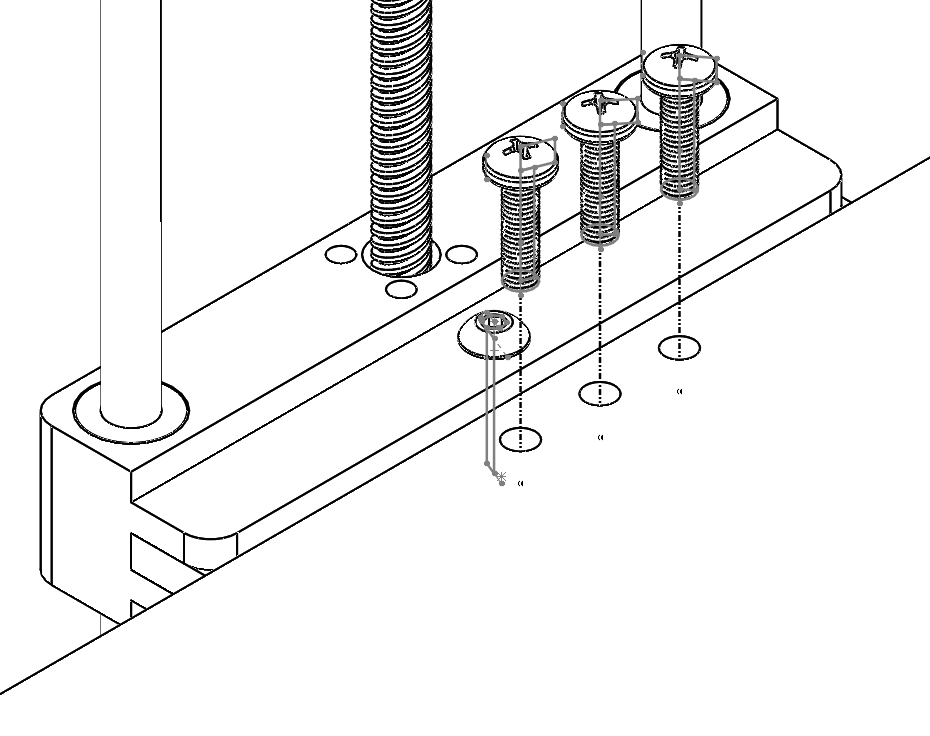
[picture p22: figure]

STEP 11: Assemble the fixture base grips with the proper fixture base using 3 M5x14 bolts and M5 nuts for each side.

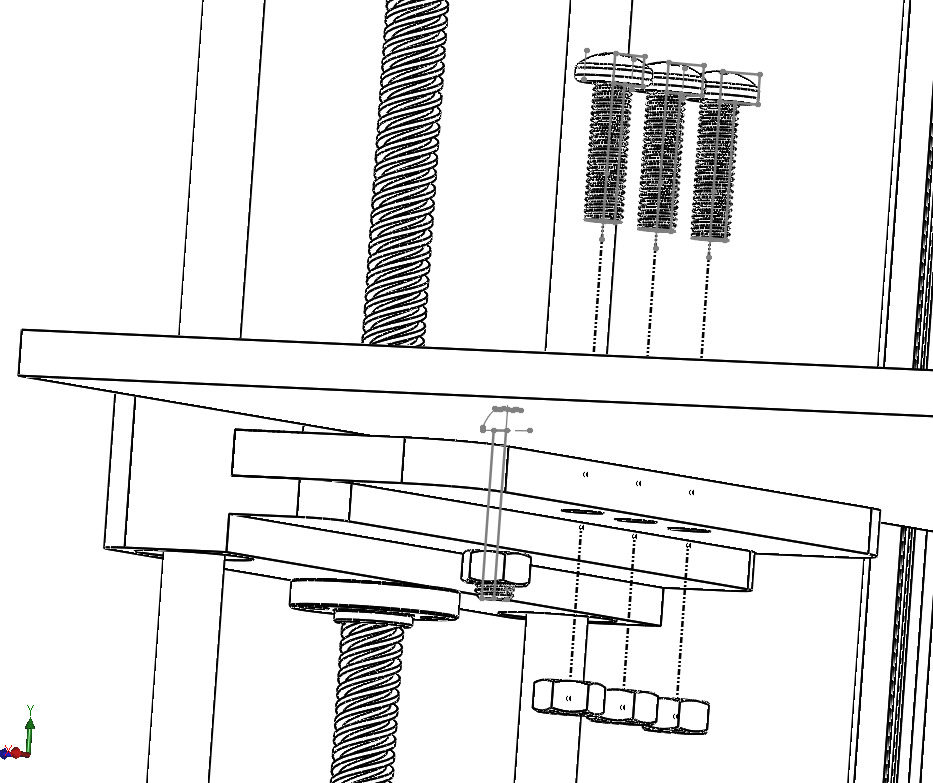
[picture p23: figure]
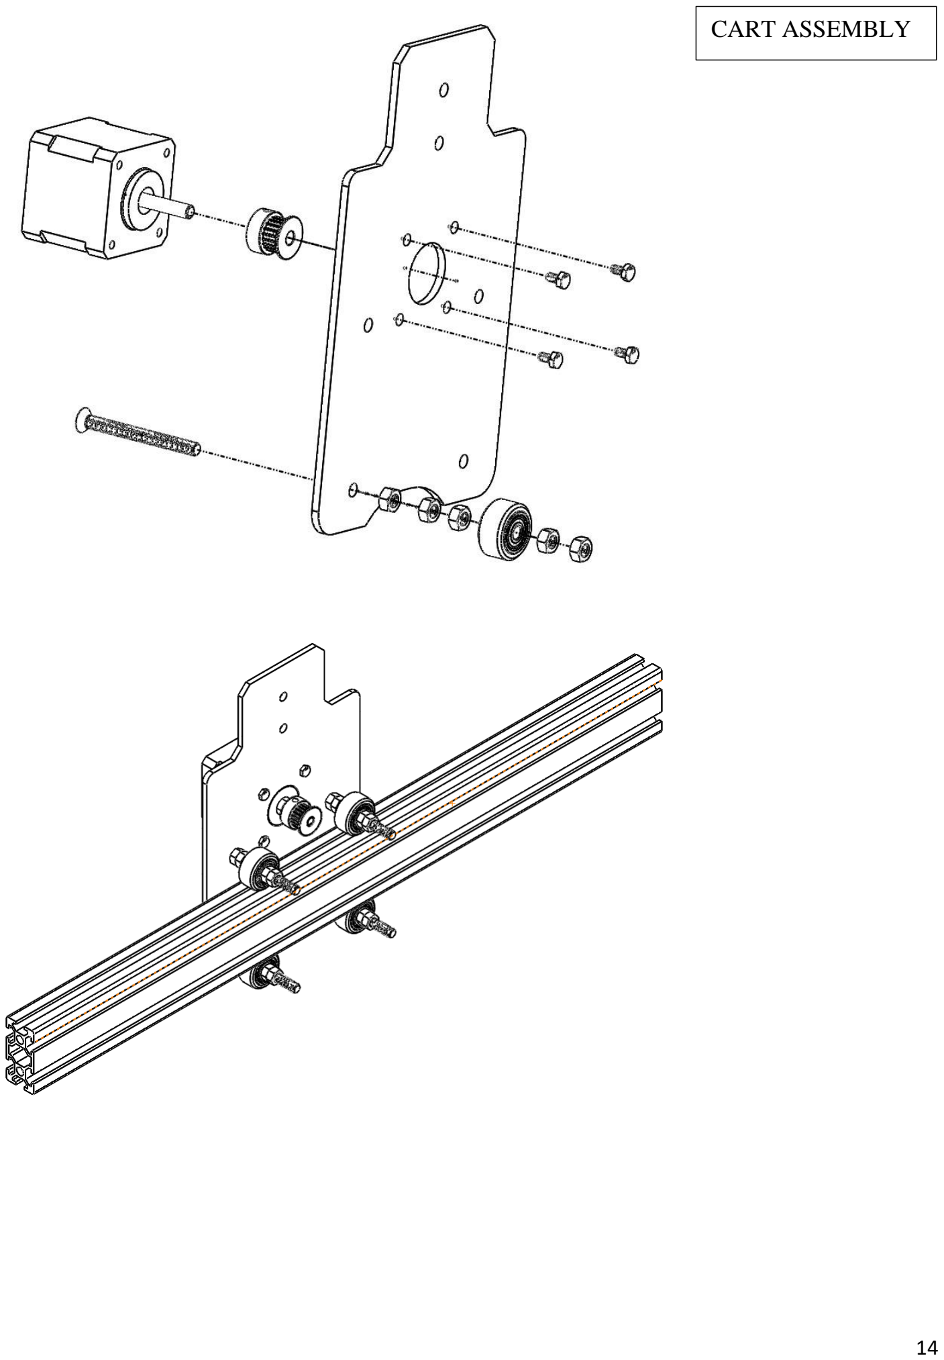
[picture p24: page 14]

CART ASSEMBLY

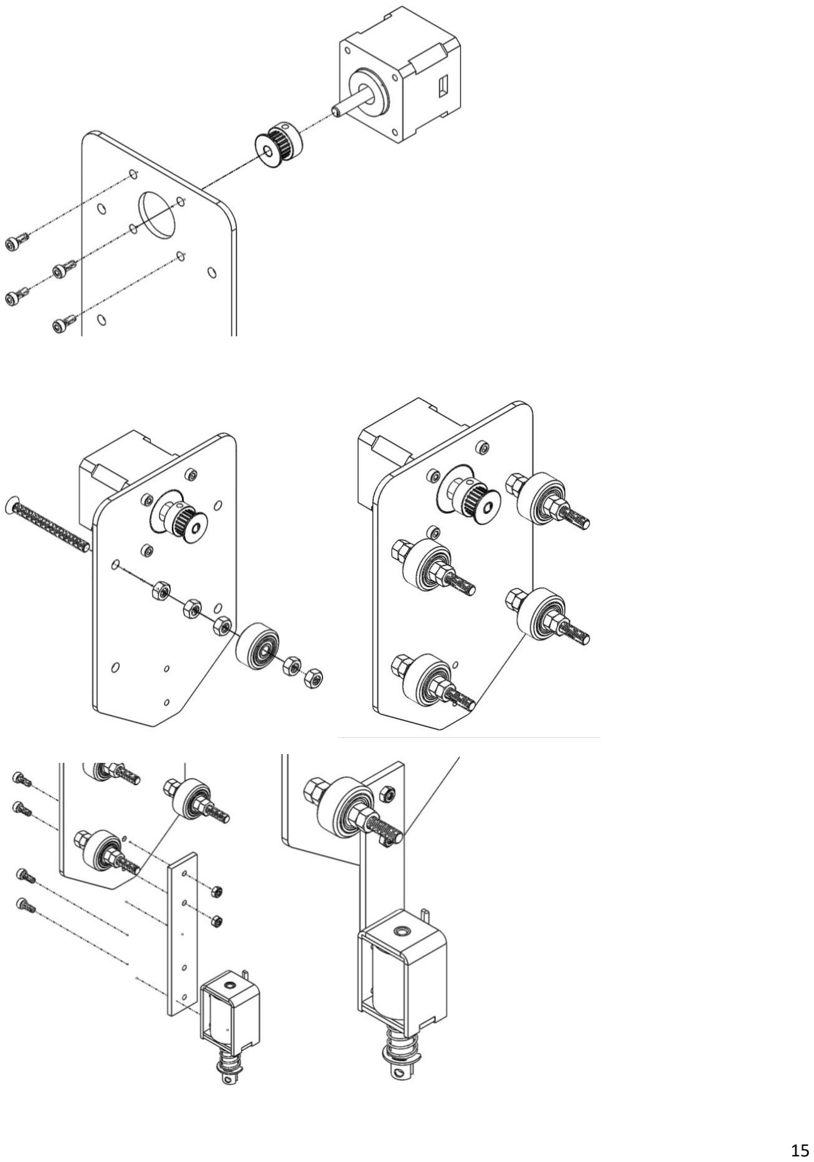
[picture p25: page 15]

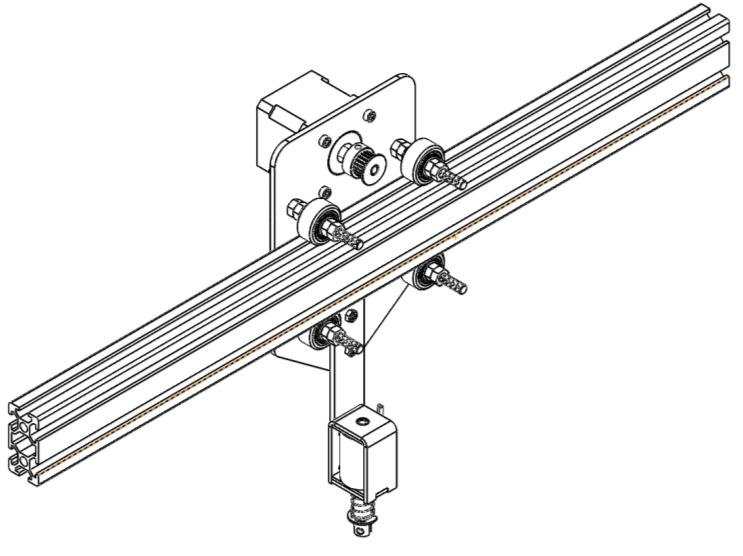
[picture p26: figure]

Cart and Profile “E”

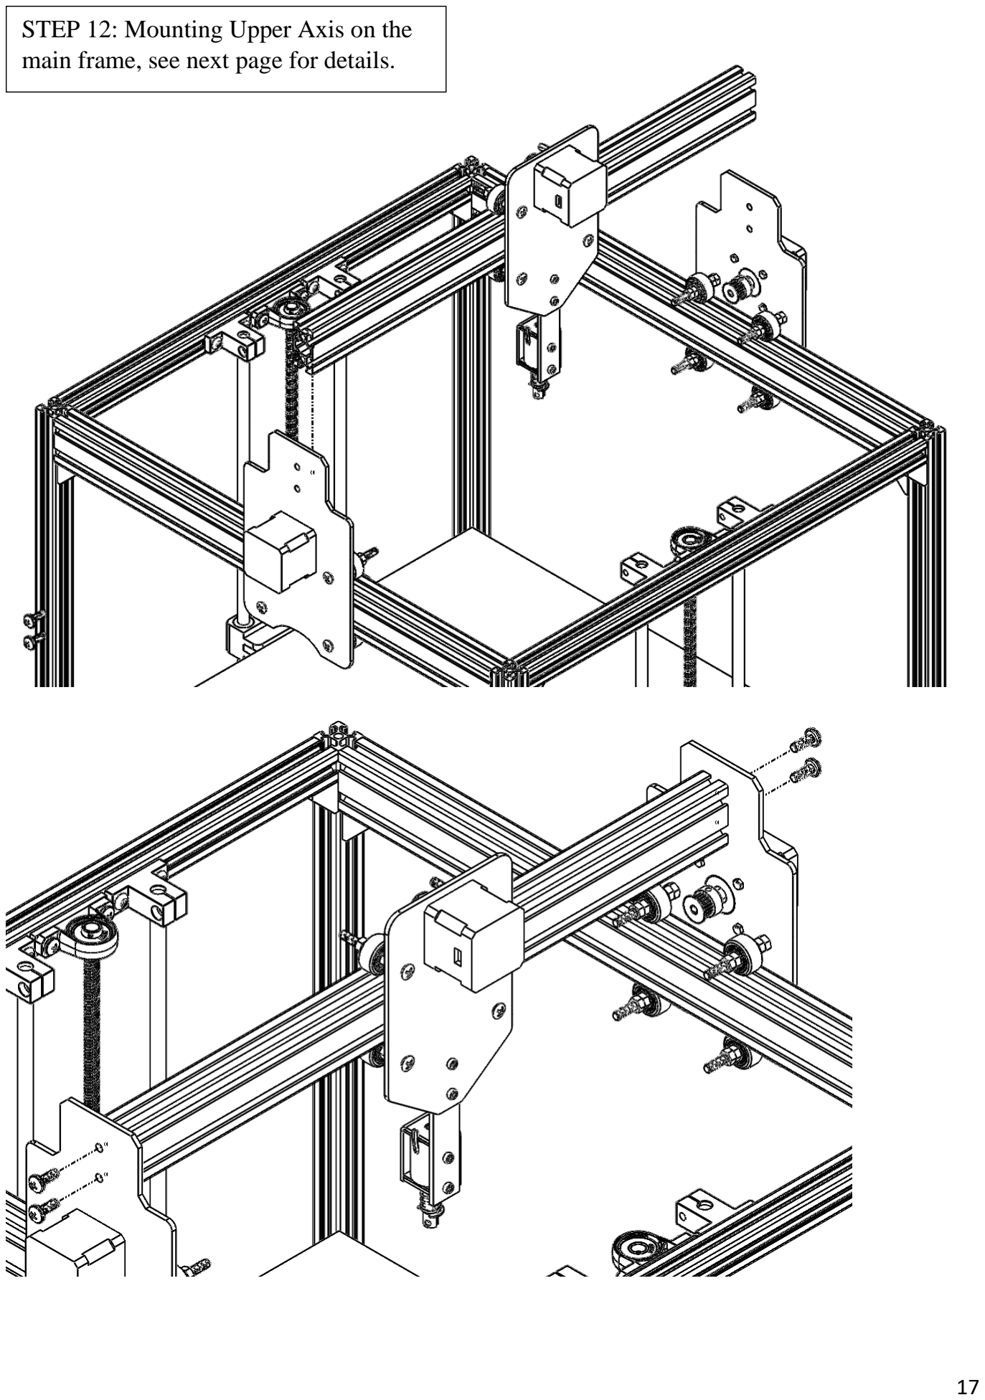
[picture p27: page 17]

STEP 12: Mounting Upper Axis on the main frame, see next page for details.

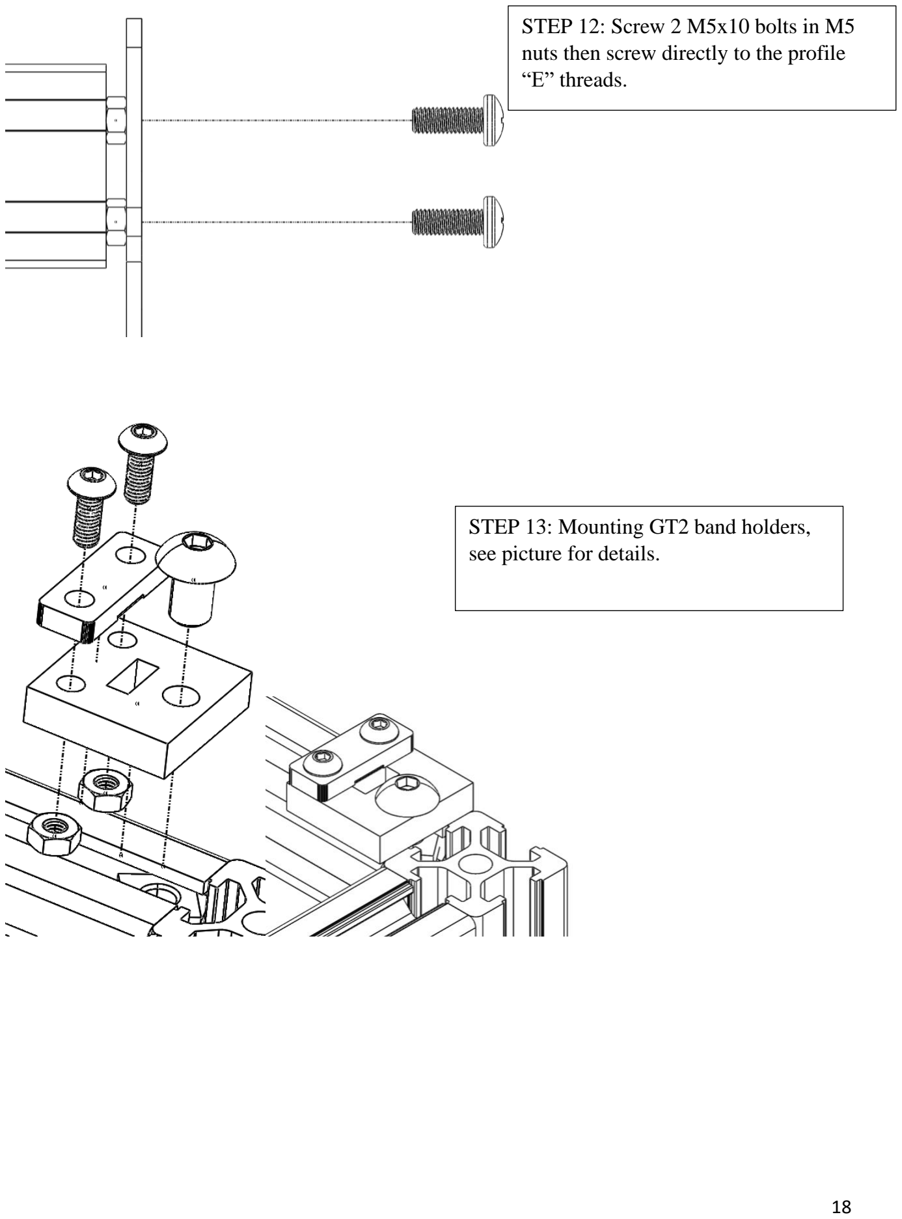
[picture p28: page 18]

STEP 12: Screw 2 M5x10 bolts in M5 nuts then screw directly to the profile “E” threads.
STEP 13: Mounting GT2 band holders, see picture for details.

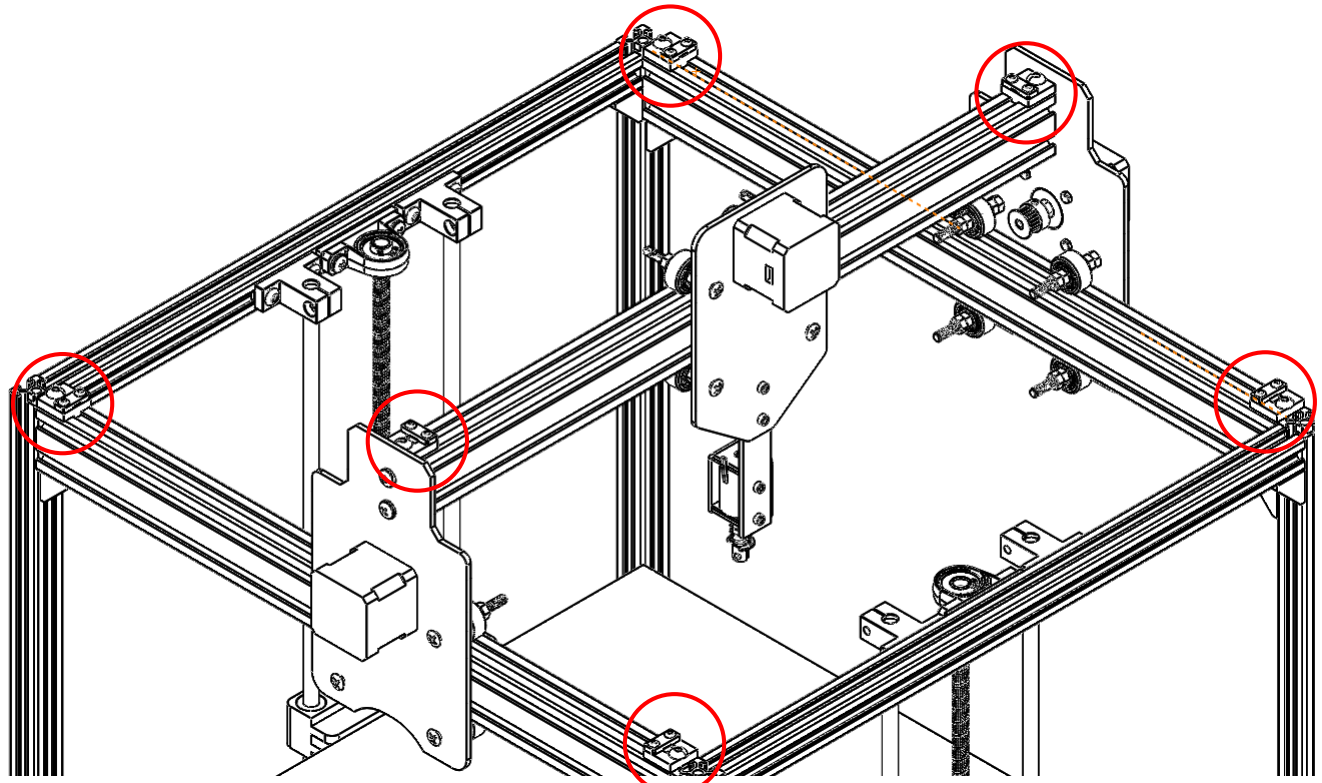
[picture p29: figure]
