WisdomSemestreI/Documentacion/Test_Case_Evaluation.xlsx

Sheet: CoverPage
SPARC WISDOM TEST CASES

Sheet: TestCase1_Loop1
Test case ID: | EVA-TSCS-001.
Test case Name: | First Evaluation related with Firmware on SPARC.
Goal: | Verify and validate that the requirements related to Serial communication and Control on SPARC firmware are correct according to Product Specifications and Requirements.
Steps:
# | Action | Expected Result | Notes | Result
1 | Turn-On and -Off the unit three times | The unit can support power lost without problems | Wait at least 10 seconds between reboots | Success SPARC support power lost without problems
2 | Open Serial Terminal at and set it to 110 baud rate. Send Init Command | Device Under test must not reset or break serial communication | The Designer should specify baudrate and be prepared to withstand errors and maintain a robust control when communication protocol is not started. If no baudrate is specified in the manual, then it should be assumed the SPARC will work with any baud rate. | Success SPARC doesn´t reset and serial communication doesn´t break
3 | Open Serial terminal at 921600 baudrate. Send Init Command | Device Under test must not reset or break serial communication | The developer must specify baudrate and prepare the SPARC firmware to robust error control when communication protocol is not started. If not baudrate then should be work with any velocity | Success SPARC doesn´t reset and serial communication doesn´t break
4 | Similar to steps 2 and 3, repeat with some specific field related to UART protocol like different stop bits, parity and data bits in the payload. | Device Under test must not reset or break serial communication | The designer should specify the configuration for their protocol and develop SPARC firmware to be prepared to control exceptions. | Success SPARC doesn´t reset and serial communication doesn´t break
5 | Configure the Serial Terminal with the comunication parameters defined by developer. Send a batch of multiple commands without delays. | Device Under Test must be able to detect invalid commands and not crash. |  | Failure SPARC crashes
6 | On Serial Terminal send the command specified by the SPARC protocol to prepare the DUT to receive commands but send an invalid command. | Device Under Test able to detect void/invalid commands
7 | Send a valid command | Device Under Test (DUT) executes the specified command | If team requiments specify an acknowledge from commands, verify in terminal that they are sent.
8 | Repeat step 6 | DUT should clear buffer of inputs/outputs (E.g. should not repeat the previous command)
9 | Send the SPARC a command to execute a Touch/Press screen. | DUT able to do Touch/Press screen.
10 | Send command to execute movement on X | DUT able to move on X | Reviewer: Take the velocity of movement and compare with the Teams requirement If team requiments specify an acknowledge from commands, verify in terminal that they are sent.
11 | Send command to execute movement on Y | DUT able to move on Y | Reviewer: Take the velocity of movement and compare with the Teams requirement If team requiments specify an acknowledge from commands, verify in terminal that they are sent.
12 | Execute multiple movements on Y that go beyond the limits of the work area. | DUT able to detect limit on Y and stop operation.
13 | Execute multiple movements on X that go beyond the limits of the work area. | DUT able to detect limit on X and stop operation.
14 | Execute a Slide screen command. | DUT able to execute Slide movements | Reviewer: Verify if team under revision has the Slide Screen Command requirement defined. If team requiments specify an acknowledge from commands, verify in terminal that they are sent.
# | Action | Expected Result | Notes | Result
Inputs:
Pre-Conditions: | TeraTerm/RealTerm or any serial terminal that allows the tester to freely select any baud rate, stop bits, payload, bit parity and configurations.
Post-Conditions:
Date Created: | 2019-12-04
Date Executed: | 2019-12-05
Tags:
Comments:

Sheet: TestCase1_Loop2
Test case ID: | EVA-TSCS-002.
Test case Name: | Second Evaluation related with Firmware on SPARC.
Goal: | Verify and validate that the requirements related to Serial communication and Control on SPARC firmware are correct according to Product Specifications and Requirements.
Steps:
# | Action | Expected Result | Notes | Result
1 | Turn-On and -Off the unit three times | The unit can support power lost without problems | Wait at least 10 seconds between reboots | Success SPARC support power lost without problems
2 | Open Serial Terminal at and set it to 110 baud rate. Send Init Command | Device Under test must not reset or break serial communication | The Designer should specify baudrate and be prepared to withstand errors and maintain a robust control when communication protocol is not started. If no baudrate is specified in the manual, then it should be assumed the SPARC will work with any baud rate. | Success SPARC doesn´t reset and serial communication doesn´t break
3 | Open Serial terminal at 921600 baudrate. Send Init Command | Device Under test must not reset or break serial communication | The developer must specify baudrate and prepare the SPARC firmware to robust error control when communication protocol is not started. If not baudrate then should be work with any velocity | Success SPARC doesn´t reset and serial communication doesn´t break
4 | Similar to steps 2 and 3, repeat with some specific field related to UART protocol like different stop bits, parity and data bits in the payload. | Device Under test must not reset or break serial communication | The designer should specify the configuration for their protocol and develop SPARC firmware to be prepared to control exceptions. | Success SPARC doesn´t reset and serial communication doesn´t break
5 | Configure the Serial Terminal with the comunication parameters defined by developer. Send a batch of multiple commands without delays. | Device Under Test must be able to detect invalid commands and not crash. |  | Success SPARC detects invelid commands and not crash
6 | On Serial Terminal send the command specified by the SPARC protocol to prepare the DUT to receive commands but send an invalid command. | Device Under Test able to detect void/invalid commands |  | Success SPARC detecs an invalid command
7 | Send a valid command | Device Under Test (DUT) executes the specified command | If team requiments specify an acknowledge from commands, verify in terminal that they are sent. | Success SPARC executes the specified command
8 | Repeat step 6 | DUT should clear buffer of inputs/outputs (E.g. should not repeat the previous command) |  | Success
9 | Send the SPARC a command to execute a Touch/Press screen. | DUT able to do Touch/Press screen. |  | Failure SPARC send the instruction but the actuator doesn´t move
10 | Send command to execute movement on X | DUT able to move on X | Reviewer: Take the velocity of movement and compare with the Teams requirement If team requiments specify an acknowledge from commands, verify in terminal that they are sent.
11 | Send command to execute movement on Y | DUT able to move on Y | Reviewer: Take the velocity of movement and compare with the Teams requirement If team requiments specify an acknowledge from commands, verify in terminal that they are sent.
12 | Execute multiple movements on Y that go beyond the limits of the work area. | DUT able to detect limit on Y and stop operation.
13 | Execute multiple movements on X that go beyond the limits of the work area. | DUT able to detect limit on X and stop operation.
14 | Execute a Slide screen command. | DUT able to execute Slide movements | Reviewer: Verify if team under revision has the Slide Screen Command requirement defined. If team requiments specify an acknowledge from commands, verify in terminal that they are sent.
# | Action | Expected Result | Notes | Result
Inputs:
Pre-Conditions: | TeraTerm/RealTerm or any serial terminal that allows the tester to freely select any baud rate, stop bits, payload, bit parity and configurations.
Post-Conditions:
Date Created: | 2019-12-06
Date Executed: | 2019-12-09
Tags:
Comments:

Sheet: TestCase1_Loop3
Test case ID: | EVA-TSCS-003.
Test case Name: | Third Evaluation related with Firmware on SPARC.
Goal: | Verify and validate that the requirements related to Serial communication and Control on SPARC firmware are correct according to Product Specifications and Requirements.
Steps:
# | Action | Expected Result | Notes | Result
1 | Turn-On and -Off the unit three times | The unit can support power lost without problems | Wait at least 10 seconds between reboots | Success SPARC support power lost without problems
2 | Open Serial Terminal at and set it to 110 baud rate. Send Init Command | Device Under test must not reset or break serial communication | The Designer should specify baudrate and be prepared to withstand errors and maintain a robust control when communication protocol is not started. If no baudrate is specified in the manual, then it should be assumed the SPARC will work with any baud rate. | Success SPARC doesn´t reset and serial communication doesn´t break
3 | Open Serial terminal at 921600 baudrate. Send Init Command | Device Under test must not reset or break serial communication | The developer must specify baudrate and prepare the SPARC firmware to robust error control when communication protocol is not started. If not baudrate then should be work with any velocity | Success SPARC doesn´t reset and serial communication doesn´t break
4 | Similar to steps 2 and 3, repeat with some specific field related to UART protocol like different stop bits, parity and data bits in the payload. | Device Under test must not reset or break serial communication | The designer should specify the configuration for their protocol and develop SPARC firmware to be prepared to control exceptions. | Success SPARC doesn´t reset and serial communication doesn´t break
5 | Configure the Serial Terminal with the comunication parameters defined by developer. Send a batch of multiple commands without delays. | Device Under Test must be able to detect invalid commands and not crash. |  | Success SPARC detects invelid commands and not crash
6 | On Serial Terminal send the command specified by the SPARC protocol to prepare the DUT to receive commands but send an invalid command. | Device Under Test able to detect void/invalid commands |  | Success SPARC detecs an invalid command
7 | Send a valid command | Device Under Test (DUT) executes the specified command | If team requiments specify an acknowledge from commands, verify in terminal that they are sent. | Success SPARC executes the command
8 | Repeat step 6 | DUT should clear buffer of inputs/outputs (E.g. should not repeat the previous command) |  | Success
9 | Send the SPARC a command to execute a Touch/Press screen. | DUT able to do Touch/Press screen. |  | Success SPARC executes a touch screen
10 | Send command to execute movement on X | DUT able to move on X | Reviewer: Take the velocity of movement and compare with the Teams requirement If team requiments specify an acknowledge from commands, verify in terminal that they are sent. | Success SPARC executes the command and sends an acknowledge
11 | Send command to execute movement on Y | DUT able to move on Y | Reviewer: Take the velocity of movement and compare with the Teams requirement If team requiments specify an acknowledge from commands, verify in terminal that they are sent. | Success SPARC executes the command and sends an acknowledge
12 | Execute multiple movements on Y that go beyond the limits of the work area. | DUT able to detect limit on Y and stop operation. |  | Success SPARC stays in position
13 | Execute multiple movements on X that go beyond the limits of the work area. | DUT able to detect limit on X and stop operation. |  | Success SPARC stays in position
14 | Execute a Slide screen command. | DUT able to execute Slide movements | Reviewer: Verify if team under revision has the Slide Screen Command requirement defined. If team requiments specify an acknowledge from commands, verify in terminal that they are sent. | Success SPARC execute a slide movement
# | Action | Expected Result | Notes | Result
Inputs:
Pre-Conditions: | TeraTerm/RealTerm or any serial terminal that allows the tester to freely select any baud rate, stop bits, payload, bit parity and configurations.
Post-Conditions:
Date Created: | 2019-12-10
Date Executed: | 2019-12-11
Tags:
Comments:
