WisdomSemestreI/Documentacion/(commit log)

2019-12-11 Manual de usuario primera version
2019-12-12 Se agrego Liga de GitHub al documento
2019-12-12 TEST CASES 1,2,3
    [Test_Case_Evaluation.xlsx]
2019-12-12 Se agregaron cambios en el manual, botón extra de encendido para actuador
2019-12-12 Code Review de SPARC
2019-12-12 Eliminar Manual de Usuario Viejo
2019-12-12 Agregar Manual de Usuario SPARC Final
2019-12-12 Agregar BOM, Deployment Diagram y Gannt Final
    [BOM.xlsx, WISDOM-GanntFinal.xlsx]
2019-12-12 Anadir Gerber
    [sparky-B_Cu.gbr, sparky-B_Mask.gbr, sparky-B_Paste.gbr, sparky-B_SilkS.gbr, sparky-Edge_Cuts.gbr, sparky-F_Cu.gbr, sparky-F_Mask.gbr, sparky-F_Paste.gbr]
